R682T962/SDII/Textron Senior Design 1/Week 16 Showcase/prototype picture.jpg

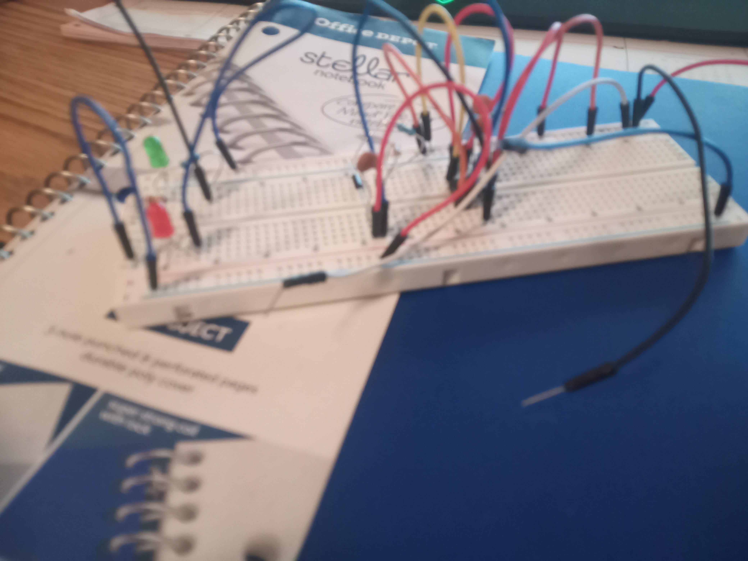
Textron Senior Design 1/Week 16 Showcase/prototype picture.jpg
