R682T962/SDII/README.txt

# SDII
Senior design 2 Textron project

Project Description can be found (these are duplicates):
SDII/Cooling Fan Monitor PCB Project Description.pdf
SDII/Textron Senior Design 1/Other/Cooling Fan Monitor PCB Project Description.pdf 

Work for each indivdual can be found in the files:
SDII/Textron Senior Design 1/Other/LTspice Models/
SDII/Textron Senior Design 2/Other/LTspice Models/
SDII/Textron Senior Design 2/Other/Altium/Melvin

Our references and meetings:
SDII/Journal/

Our current Prototype/math:
SDII/Textron Senior Design 2/Other/Current work summary/

.asc files are LTspice files.
