R682T962/SDII/Textron Senior Design 1/Week 11 Block Diagram/R682T962 Block diagram.pdf

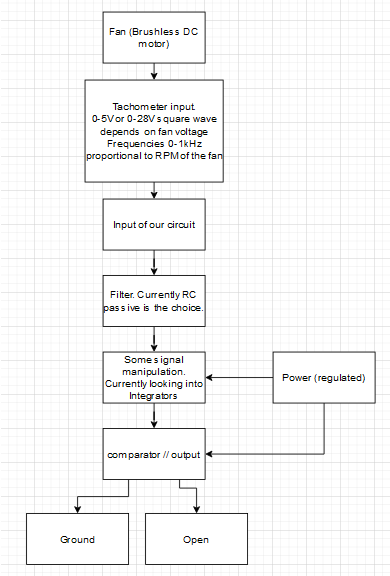
[picture p25: page 1]

Circuit Block diagram from Tachometere input

Block Diagram of the whole circuit

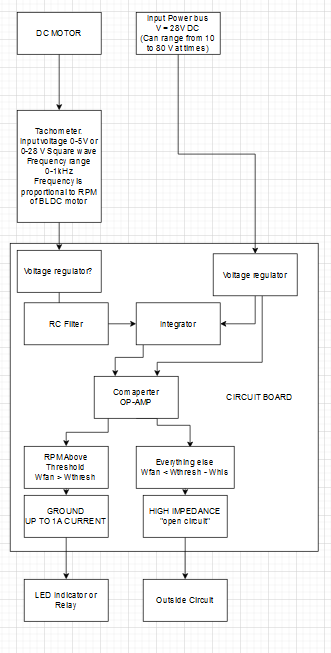
[picture p26: figure]
