R682T962/SDII/Textron Senior Design 1/Week 6 Project planning paper/Individual Skills Matrix_Mel.xlsx

 | Basic | Intermed | Adv | Want to Learn | This is about your experience level in various catagories. There are no right or wrong answers! This is a self-assessment scale, and each person may have a different 'value' for what basic, intermediate, and advanced means.
Software
Dev. methods |  |  |  |  | Agile, SCRUM, Waterfall, Lean, Feature Driven, etc.
Dev. Environ. | X |  |  |  | exposure to build, test, debug, compile, etc.
Config. Mgmt. |  |  |  |  | processes, tools, methodologies
Debug tools |  |  |  |  | simulators, emulators, probes, etc.
Create Code | X |  |  |  | exposure Java, JSON, C++, C#, etc.
Flowchart | X |  |  |  | standard symbology, can you prototype code with flowchart
Protocols |  |  |  |  | comms, streams, templates, patterns, etc.
Data security |  |  |  |  | data at rest, during transport, I&A levels, etc.
Database |  |  |  |  | Oracle, Sybase, MS-SQL, SQL, Access, etc.
Electrical
Power devices |  |  |  |  | FET, IGBT, NPN/PNP, MOV, etc.
Filters |  |  |  |  | line, tank trap, HF noise, ripple, etc.
Amplifiers | X |  |  |  | band pass, low pass, power line, HF, LF, etc.
Comms |  |  |  |  | communications over a serial bus of some kind, voip, slip, etc
Power supply |  |  |  |  | linear, switching, buck, boost, etc.
Converters |  |  |  |  | analog to digital, digital to analog, voltage to current, etc.
Logical | X |  |  |  | basic gates and respresentation via schematic
Simulation |  |  |  |  | schematic capture to sim, VHDL to sim, etc.
RF devices |  |  |  |  | antenna design, bluetooth, wifi, walkies, etc.
Prog. devices |  |  |  |  | FPGA, PLD, PLA, SOC, etc.
Computing
Single board |  |  |  |  | optimized for specific use, general purpose, etc.
Operating Sys | X |  |  |  | Windows, Unix, RTOS, etc.
Interfaces |  |  |  |  | OSI reference model,
Networks |  |  |  |  | star, token ring, bus, line, tree, mesh, etc.
Microprocessor |  |  |  |  | RISC, multi-core, low power, 8/16/32/64 bit, multi-thread
Microcontroller |  |  |  |  | on-board peripherals added to microprocessor
General
Prog. Controller | X |  |  |  | state machines, RLL, ladder, etc.
I/O modules | X |  |  |  | dry contact in/out, AC in/out, DC in/out, analog in/out, etc.
Sensors | X |  |  |  | capacitance, ultrasonic, IR, inductive, light, heat, etc.
Actuators |  |  |  |  | linear, push-pull, rotational, etc.
Motors | X |  |  |  | DC, brushless, AC, stepper, etc.
Solenoids |  |  |  |  | translate ele to mech, control flow, control power, etc.
Engr. Business
Requirements | X |  |  |  | the life cycle of requirements from gathering to final test
Trade Study |  |  |  |  | how-to do, when to do, making decisions on
Diagraming |  |  |  |  | flow, acquisition, resource, etc.
Tech Writing | X |  |  |  | style, grammar, user manuals, etc.
Communication |  | X |  |  | how to present to different kinds of audiences
Statement of Work |  | X |  |  | seen one, written one, used one, etc.
Conduct Research
Library |  | X |  |  | reference library vs all things Google
Tech Journals |  | X |  |  | where to look for specific industry tech data
Market | X |  |  |  | how to find the market for a specific kind of device
Product analysis |  | X |  |  | how to compare and weight features
Regulatory |  |  |  |  | Gov, industry, agency, compliance, restrictions, etc.
Standards |  |  |  |  | best practices, fielding devices, industry standards, etc.
Project Mgmt
Team organization |  | X
Minutes | X
Metrics | X
Schedule |  | X
Cost |  | X
Tracking |  | X
Visibility |  | X
Presentation |  | X
Reporting |  | X
 | Need intro | Have used | Can teach | Want to Learn
Oscilloscope | X |  |  | X
Logic Analyzer | X |  |  | X
DVM | X |  |  | X
Current probe | X |  |  | X
Freq. Analyzer | X |  |  | X
Spectrum Analyzer | X |  |  | X
Device programmer | X |  |  | X
Soldering iron |  | X |  | X
De-soldering station | X |  |  | X
Breadboard | X |  |  | X
Point-to-point |  |  |  | X
Perf-board |  |  |  | X
3-D Printer |  |  |  | X
Laser Cutter | X |  |  | X
PCB Design |  |  |  | X
PCB Manufacture |  |  |  | X
Component level troubleshooting |  |  |  | X
