R682T962/SDII/Textron Senior Design 1/Week 6 Project planning paper/R682T962 Individual Skills Matrix.xlsx

 | Basic | Intermed | Adv | Want to Learn | This is about your experience level in various catagories. There are no right or wrong answers! This is a self-assessment scale, and each person may have a different 'value' for what basic, intermediate, and advanced means.
Software
Dev. methods | 1 |  |  |  | Agile, SCRUM, Waterfall, Lean, Feature Driven, etc.
Dev. Environ. |  | 1 |  |  | exposure to build, test, debug, compile, etc.
Config. Mgmt. | 1 |  |  |  | processes, tools, methodologies
Debug tools | 1 |  |  |  | simulators, emulators, probes, etc.
Create Code |  | 1 |  |  | exposure Java, JSON, C++, C#, etc.
Flowchart | 1 |  |  |  | standard symbology, can you prototype code with flowchart
Protocols | 1 |  |  |  | comms, streams, templates, patterns, etc.
Data security | 1 |  |  |  | data at rest, during transport, I&A levels, etc.
Database | 1 |  |  |  | Oracle, Sybase, MS-SQL, SQL, Access, etc.
Electrical
Power devices |  | 1 |  | 1 | FET, IGBT, NPN/PNP, MOV, etc.
Filters | 1 |  |  | 1 | line, tank trap, HF noise, ripple, etc.
Amplifiers | 1 |  |  | 1 | band pass, low pass, power line, HF, LF, etc.
Comms | 1 |  |  | 1 | communications over a serial bus of some kind, voip, slip, etc
Power supply | 1 |  |  | 1 | linear, switching, buck, boost, etc.
Converters |  | 1 |  | 1 | analog to digital, digital to analog, voltage to current, etc.
Logical |  | 1 |  | 1 | basic gates and respresentation via schematic
Simulation |  | 1 |  |  | schematic capture to sim, VHDL to sim, etc.
RF devices | 1 |  |  | 1 | antenna design, bluetooth, wifi, walkies, etc.
Prog. devices | 1 |  |  |  | FPGA, PLD, PLA, SOC, etc.
Computing
Single board | 1 |  |  |  | optimized for specific use, general purpose, etc.
Operating Sys | 1 |  |  |  | Windows, Unix, RTOS, etc.
Interfaces | 1 |  |  |  | OSI reference model,
Networks | 1 |  |  |  | star, token ring, bus, line, tree, mesh, etc.
Microprocessor | 1 |  |  |  | RISC, multi-core, low power, 8/16/32/64 bit, multi-thread
Microcontroller | 1 |  |  |  | on-board peripherals added to microprocessor
General
Prog. Controller | 1 |  |  |  | state machines, RLL, ladder, etc.
I/O modules |  | 1 |  | 1 | dry contact in/out, AC in/out, DC in/out, analog in/out, etc.
Sensors | 1 |  |  | 1 | capacitance, ultrasonic, IR, inductive, light, heat, etc.
Actuators | 1 |  |  |  | linear, push-pull, rotational, etc.
Motors | 1 |  |  | 1 | DC, brushless, AC, stepper, etc.
Solenoids | 1 |  |  | 1 | translate ele to mech, control flow, control power, etc.
Engr. Business
Requirements | 1 |  |  | 1 | the life cycle of requirements from gathering to final test
Trade Study | 1 |  |  | 1 | how-to do, when to do, making decisions on
Diagraming | 1 |  |  | 1 | flow, acquisition, resource, etc.
Tech Writing | 1 |  |  | 1 | style, grammar, user manuals, etc.
Communication | 1 |  |  | 1 | how to present to different kinds of audiences
Statement of Work | 1 |  |  | 1 | seen one, written one, used one, etc.
Conduct Research
Library |  | 1 |  | 1 | reference library vs all things Google
Tech Journals | 1 |  |  | 1 | where to look for specific industry tech data
Market | 1 |  |  | 1 | how to find the market for a specific kind of device
Product analysis | 1 |  |  | 1 | how to compare and weight features
Regulatory | 1 |  |  | 1 | Gov, industry, agency, compliance, restrictions, etc.
Standards | 1 |  |  | 1 | best practices, fielding devices, industry standards, etc.
Project Mgmt
Team organization |  | 1
Minutes | 1
Metrics | 1
Schedule |  | 1
Cost |  | 1
Tracking |  | 1
Visibility | 1
Presentation |  | 1
Reporting |  | 1
 | Need intro | Have used | Can teach | Want to Learn
Oscilloscope |  | 1
Logic Analyzer | 1
DVM | 1
Current probe | 1 |  |  | 1
Freq. Analyzer | 1 |  |  | 1
Spectrum Analyzer | 1 |  |  | 1
Device programmer | 1
Soldering iron |  | 1 |  | 1
De-soldering station | 1 |  |  | 1
Breadboard |  | 1
Point-to-point | 1
Perf-board | 1
3-D Printer |  | 1 |  | 1
Laser Cutter | 1 |  |  | 1
PCB Design | 1 |  |  | 1
PCB Manufacture | 1 |  |  | 1
Component level troubleshooting | 1 |  |  | 1
