R682T962/SDII/Textron Senior Design 1/Week 6 Project planning paper/Team Skills Matrix.xlsx

Sheet: Melvin St.John
 |  | Basic | Intermed | Adv | Want to Learn
Software
Dev. methods | 1
Dev. Environ. | 0 | 1
Config. Mgmt. | 1
Debug tools | 1
Create Code | 0 | 1
Flowchart | 0 | 1
Protocols | 1
Data security | 1
Database | 1
Electrical | 1
Power devices | 1 |  |  |  | 1
Filters | 0 | 1 |  |  | 1
Amplifiers | 0 | 1 |  |  | 1
Comms | 1 |  |  |  | 1
Power supply | 0 | 1 |  |  | 1
Converters | 1 |  |  |  | 1
Logical | 0 | 1 |  |  | 1
Simulation | 0 | 1 |  |  | 1
RF devices | 1 |  |  |  | 1
Prog. devices | 0 | 1 |  |  | 1
Computing | 1 |  |  |  | 1
Single board | 1 |  |  |  | 1
Operating Sys | 0 | 1 |  |  | 1
Interfaces | 0 | 1 |  |  | 1
Networks | 1 |  |  |  | 1
Microprocessor | 1 |  |  |  | 1
Microcontroller | 1 |  |  |  | 1
General | 1
Prog. Controller | 0 | 1 |  |  | 1
I/O modules | 0 | 1 |  |  | 1
Sensors | 0 | 1 |  |  | 1
Actuators | 1 |  |  |  | 1
Motors | 0 | 1 |  |  | 1
Solenoids | 1 |  |  |  | 1
Engr. Develop. | 1
Requirements | 0 | 1 |  |  | 1
Trade Study | 1 |  |  |  | 1
Diagraming | 1 |  |  |  | 1
Tech Writing | 0 | 1 |  |  | 1
Communication | 0 |  | 1 |  | 1
Statement of Work | 0 |  | 1 |  | 1
Conduct Research | 1
Library | 0 | 1 |  |  | 1
Tech Journals | 0 | 1 |  |  | 1
Market | 0 | 1 |  |  | 1
Product analysis | 0 |  | 1 |  | 1
Regulatory | 0 | 1 |  |  | 1
Standards | 0 | 1 |  |  | 1
Project Mgmt | 0 |  | 1
Team organization | 0 |  | 1 |  | 1
Minutes | 0 |  | 1
Metrics | 0 | 1 |  |  | 1
Schedule | 0 |  | 1 |  | 1
Cost | 0 |  | 1 |  | 1
Tracking | 0 | 1 |  |  | 1
Visibility | 0 |  | 1
Presentation | 0 |  | 1 |  | 1
Reporting | 0 |  | 1 |  | 1
 | 1
 | 1
 | #VALUE! | Need intro | Have used | Can teach | Want to Learn
Oscilloscope | 0 |  | 1 |  | 1
Logic Analyzer | 0 | 1 |  |  | 1
DVM | 0 | 1 |  |  | 1
Current probe | 0 |  | 1
Freq. Analyzer | 0 |  | 1 |  | 1
Spectrum Analyzer | 0 | 1 |  |  | 1
Device programmer | 0 | 1 |  |  | 1
Soldering iron | 0 |  | 1 | 1
De-soldering station | 0 | 1 |  |  | 1
Breadboard | 0 |  | 1 |  | 1
Point-to-point | 0 | 1 |  |  | 1
Perf-board | 0 | 1 |  |  | 1
3-D Printer | 0 | 1 |  |  | 1
Laser Cutter | 0 |  | 1 |  | 1
PCB Design | 0 | 1 |  |  | 1
PCB Manufacture | 0 | 1 |  |  | 1
Component level troubleshooting | 0 | 1 |  |  | 1
 | 1
 | 1
 | 1
 | 1
 | 1
 | 1

Sheet: Ayham Sabra
 |  | Basic | Intermed | Adv | Want to Learn
Software
Dev. methods | 1
Dev. Environ. | 0 | 1
Config. Mgmt. | 1
Debug tools | 1
Create Code | 0 |  | 1 |  | 1
Flowchart | 1 |  |  |  | 1
Protocols | 1 |  |  |  | 1
Data security | 1 |  |  |  | 1
Database | 1 |  |  |  | 1
Electrical
Power devices | 0 |  | 1 |  | 1
Filters | 0 | 1 |  |  | 1
Amplifiers | 0 | 1 |  |  | 1
Comms | 1 |  |  |  | 1
Power supply | 0 | 1 |  |  | 1
Converters | 0 | 1 |  |  | 1
Logical | 0 | 1 |  |  | 1
Simulation | 0 |  | 1 |  | 1
RF devices | 1 |  |  |  | 1
Prog. devices | 1
Computing
Single board | 0 | 1 |  |  | 1
Operating Sys | 0 | 1
Interfaces | 1
Networks | 1
Microprocessor | 1
Microcontroller | 1 |  |  |  | 1
General
Prog. Controller | 1
I/O modules | 0 |  | 1 |  | 1
Sensors | 0 | 1 |  |  | 1
Actuators | 0 | 1 |  |  | 1
Motors | 0 | 1 |  |  | 1
Solenoids | 0 | 1 |  |  | 1
Engr. Develop.
Requirements | 0 | 1 |  |  | 1
Trade Study | 1 |  |  |  | 1
Diagraming | 1 |  |  |  | 1
Tech Writing | 1 |  |  |  | 1
Communication | 0 | 1 |  |  | 1
Statement of Work | 1 |  |  |  | 1
Conduct Research
Library | 0 |  | 1 |  | 1
Tech Journals | 1 |  |  |  | 1
Market | 1 |  |  |  | 1
Product analysis | 1 |  |  |  | 1
Regulatory | 1 |  |  |  | 1
Standards | 1 |  |  |  | 1
Project Mgmt | 1
Team organization | 0 |  | 1 |  | 1
Minutes | 0 | 1
Metrics | 1
Schedule | 0 |  | 1 |  | 1
Cost | 0 |  | 1 |  | 1
Tracking | 1 |  |  |  | 1
Visibility | 1 |  |  |  | 1
Presentation | 0 | 1 |  |  | 1
Reporting | 0 | 1 |  |  | 1
 |  | Need intro | Have used | Can teach | Want to Learn
Oscilloscope | 0 |  | 1 |  | 1
Logic Analyzer | 0 | 1 |  |  | 1
DVM | 0 | 1 |  |  | 1
Current probe | 0 | 1 |  |  | 1
Freq. Analyzer | 0 | 1 |  |  | 1
Spectrum Analyzer | 0 | 1 |  |  | 1
Device programmer | 0 | 1
Soldering iron | 0 |  | 1 |  | 1
De-soldering station | 0 | 1 |  |  | 1
Breadboard | 0 |  | 1
Point-to-point | 0 | 1
Perf-board | 0 | 1
3-D Printer | 0 |  | 1 |  | 1
Laser Cutter | 1
PCB Design | 0 | 1 |  |  | 1
PCB Manufacture | 0 | 1 |  |  | 1
Component level troubleshooting | 0 | 1 |  |  | 1

Sheet: Cody White
 |  | Basic | Intermed | Adv | Want to Learn
Software
Dev. methods |  | 1
Dev. Environ. |  | 1
Config. Mgmt. |  |  | 1
Debug tools |  |  | 1
Create Code |  | 1 |  |  | 1
Flowchart |  |  | 1
Protocols |  |  | 1
Data security |  | 1 |  |  | 1
Database | 1
Electrical
Power devices |  |  | 1 |  | 1
Filters |  | 1 |  |  | 1
Amplifiers |  | 1 |  |  | 1
Comms |  | 1 |  |  | 1
Power supply |  |  | 1 |  | 1
Converters |  |  | 1 |  | 1
Logical |  |  | 1 |  | 1
Simulation |  |  | 1 |  | 1
RF devices | 1 |  |  |  | 1
Prog. devices | 1 |  |  |  | 1
Computing
Single board |  | 1
Operating Sys |  | 1
Interfaces | 1
Networks |  | 1
Microprocessor | 1 |  |  |  | 1
Microcontroller | 1 |  |  |  | 1
General
Prog. Controller |  | 1 |  |  | 1
I/O modules |  | 1 |  |  | 1
Sensors |  | 1 |  |  | 1
Actuators | 1 |  |  |  | 1
Motors |  | 1 |  |  | 1
Solenoids |  | 1 |  |  | 1
Engr. Develop.
Requirements |  |  | 1
Trade Study |  | 1 |  |  | 1
Diagraming |  |  | 1
Tech Writing |  | 1 |  |  | 1
Communication |  |  | 1
Statement of Work |  |  | 1
Conduct Research
Library |  |  | 1
Tech Journals |  |  | 1
Market |  | 1
Product analysis |  |  | 1
Regulatory |  | 1
Standards |  |  | 1
Project Mgmt
Team organization |  |  | 1
Minutes |  |  | 1
Metrics |  |  | 1
Schedule |  |  | 1
Cost |  |  | 1
Tracking |  |  | 1
Visibility |  |  | 1
Presentation |  |  |  | 1
Reporting |  |  |  | 1
 |  | Need intro | Have used | Can teach | Want to Learn
Oscilloscope |  |  | 1 |  | 1
Logic Analyzer |  | 1 |  |  | 1
DVM |  | 1 |  |  | 1
Current probe |  |  | 1 |  | 1
Freq. Analyzer |  | 1 |  |  | 1
Spectrum Analyzer |  | 1 |  |  | 1
Device programmer |  | 1 |  |  | 1
Soldering iron |  |  | 1 |  | 1
De-soldering station |  | 1 |  |  | 1
Breadboard |  |  | 1 |  | 1
Point-to-point |  | 1 |  |  | 1
Perf-board |  | 1 |  |  | 1
3-D Printer |  |  | 1 |  | 1
Laser Cutter |  |  | 1 |  | 1
PCB Design |  | 1 |  |  | 1
PCB Manufacture |  | 1 |  |  | 1
Component level troubleshooting |  |  | 1 |  | 1

Sheet: person4
 | Basic | Intermed | Adv | Want to Learn
Software
Dev. methods
Dev. Environ.
Config. Mgmt.
Debug tools
Create Code
Flowchart
Protocols
Data security
Database
Electrical
Power devices
Filters
Amplifiers
Comms
Power supply
Converters
Logical
Simulation
RF devices
Prog. devices
Computing
Single board
Operating Sys
Interfaces
Networks
Microprocessor
Microcontroller
General
Prog. Controller
I/O modules
Sensors
Actuators
Motors
Solenoids
Engr. Develop.
Requirements
Trade Study
Diagraming
Tech Writing
Communication
Statement of Work
Conduct Research
Library
Tech Journals
Market
Product analysis
Regulatory
Standards
Project Mgmt
Team organization
Minutes
Metrics
Schedule
Cost
Tracking
Visibility
Presentation
Reporting
 | Need intro | Have used | Can teach | Want to Learn
Oscilloscope
Logic Analyzer
DVM
Current probe
Freq. Analyzer
Spectrum Analyzer
Device programmer
Soldering iron
De-soldering station
Breadboard
Point-to-point
Perf-board
3-D Printer
Laser Cutter
PCB Design
PCB Manufacture
Component level troubleshooting

Sheet: person5
 | Basic | Intermed | Adv | Want to Learn
Software
Dev. methods
Dev. Environ.
Config. Mgmt.
Debug tools
Create Code
Flowchart
Protocols
Data security
Database
Electrical
Power devices
Filters
Amplifiers
Comms
Power supply
Converters
Logical
Simulation
RF devices
Prog. devices
Computing
Single board
Operating Sys
Interfaces
Networks
Microprocessor
Microcontroller
General
Prog. Controller
I/O modules
Sensors
Actuators
Motors
Solenoids
Engr. Develop.
Requirements
Trade Study
Diagraming
Tech Writing
Communication
Statement of Work
Conduct Research
Library
Tech Journals
Market
Product analysis
Regulatory
Standards
Project Mgmt
Team organization
Minutes
Metrics
Schedule
Cost
Tracking
Visibility
Presentation
Reporting
 | Need intro | Have used | Can teach | Want to Learn
Oscilloscope
Logic Analyzer
DVM
Current probe
Freq. Analyzer
Spectrum Analyzer
Device programmer
Soldering iron
De-soldering station
Breadboard
Point-to-point
Perf-board
3-D Printer
Laser Cutter
PCB Design
PCB Manufacture
Component level troubleshooting

Sheet: person6
 | Basic | Intermed | Adv | Want to Learn
Software
Dev. methods
Dev. Environ.
Config. Mgmt.
Debug tools
Create Code
Flowchart
Protocols
Data security
Database
Electrical
Power devices
Filters
Amplifiers
Comms
Power supply
Converters
Logical
Simulation
RF devices
Prog. devices
Computing
Single board
Operating Sys
Interfaces
Networks
Microprocessor
Microcontroller
General
Prog. Controller
I/O modules
Sensors
Actuators
Motors
Solenoids
Engr. Develop.
Requirements
Trade Study
Diagraming
Tech Writing
Communication
Statement of Work
Conduct Research
Library
Tech Journals
Market
Product analysis
Regulatory
Standards
Project Mgmt
Team organization
Minutes
Metrics
Schedule
Cost
Tracking
Visibility
Presentation
Reporting
 | Need intro | Have used | Can teach | Want to Learn
Oscilloscope
Logic Analyzer
DVM
Current probe
Freq. Analyzer
Spectrum Analyzer
Device programmer
Soldering iron
De-soldering station
Breadboard
Point-to-point
Perf-board
3-D Printer
Laser Cutter
PCB Design
PCB Manufacture
Component level troubleshooting

Sheet: person7
 | Basic | Intermed | Adv | Want to Learn
Software
Dev. methods
Dev. Environ.
Config. Mgmt.
Debug tools
Create Code
Flowchart
Protocols
Data security
Database
Electrical
Power devices
Filters
Amplifiers
Comms
Power supply
Converters
Logical
Simulation
RF devices
Prog. devices
Computing
Single board
Operating Sys
Interfaces
Networks
Microprocessor
Microcontroller
General
Prog. Controller
I/O modules
Sensors
Actuators
Motors
Solenoids
Engr. Develop.
Requirements
Trade Study
Diagraming
Tech Writing
Communication
Statement of Work
Conduct Research
Library
Tech Journals
Market
Product analysis
Regulatory
Standards
Project Mgmt
Team organization
Minutes
Metrics
Schedule
Cost
Tracking
Visibility
Presentation
Reporting
 | Need intro | Have used | Can teach | Want to Learn
Oscilloscope
Logic Analyzer
DVM
Current probe
Freq. Analyzer
Spectrum Analyzer
Device programmer
Soldering iron
De-soldering station
Breadboard
Point-to-point
Perf-board
3-D Printer
Laser Cutter
PCB Design
PCB Manufacture
Component level troubleshooting

Sheet: Team skills rollup
 | None | Basic | Intermed | Adv | Want to Learn
Software
Dev. methods | 2 | 1 | 0 | 0 | 0
Dev. Environ. | 0 | 3 | 0 | 0 | 0
Config. Mgmt. | 2 | 0 | 1 | 0 | 0
Debug tools | 2 | 0 | 1 | 0 | 0
Create Code | 0 | 2 | 1 | 0 | 2
Flowchart | 1 | 1 | 1 | 0 | 1
Protocols | 2 | 0 | 1 | 0 | 1
Data security | 2 | 1 | 0 | 0 | 2
Database | 3 | 0 | 0 | 0 | 1
Electrical
Power devices | 1 | 0 | 2 | 0 | 3
Filters | 0 | 3 | 0 | 0 | 3
Amplifiers | 0 | 3 | 0 | 0 | 3
Comms | 2 | 1 | 0 | 0 | 3
Power supply | 0 | 2 | 1 | 0 | 3
Converters | 1 | 1 | 1 | 0 | 3
Logical | 0 | 2 | 1 | 0 | 3
Simulation | 0 | 1 | 2 | 0 | 3
RF devices | 3 | 0 | 0 | 0 | 3
Prog. devices | 2 | 1 | 0 | 0 | 2
Computing
Single board | 1 | 2 | 0 | 0 | 2
Operating Sys | 0 | 3 | 0 | 0 | 1
Interfaces | 2 | 1 | 0 | 0 | 1
Networks | 2 | 1 | 0 | 0 | 1
Microprocessor | 3 | 0 | 0 | 0 | 2
Microcontroller | 3 | 0 | 0 | 0 | 3
General
Prog. Controller | 1 | 2 | 0 | 0 | 2
I/O modules | 0 | 2 | 1 | 0 | 3
Sensors | 0 | 3 | 0 | 0 | 3
Actuators | 2 | 1 | 0 | 0 | 3
Motors | 0 | 3 | 0 | 0 | 3
Solenoids | 1 | 2 | 0 | 0 | 3
Engr. Develop.
Requirements | 0 | 2 | 1 | 0 | 2
Trade Study | 2 | 1 | 0 | 0 | 3
Diagraming | 2 | 0 | 1 | 0 | 2
Tech Writing | 1 | 2 | 0 | 0 | 3
Communication | 0 | 1 | 2 | 0 | 2
Statement of Work | 1 | 0 | 2 | 0 | 2
Conduct Research
Library | 0 | 1 | 2 | 0 | 2
Tech Journals | 1 | 1 | 1 | 0 | 2
Market | 1 | 2 | 0 | 0 | 2
Product analysis | 1 | 0 | 2 | 0 | 2
Regulatory | 1 | 2 | 0 | 0 | 2
Standards | 1 | 1 | 1 | 0 | 2
Project Mgmt
Team organization | 0 | 0 | 3 | 0 | 2
Minutes | 0 | 1 | 2 | 0 | 0
Metrics | 1 | 1 | 1 | 0 | 1
Schedule | 0 | 0 | 3 | 0 | 2
Cost | 0 | 0 | 3 | 0 | 2
Tracking | 1 | 1 | 1 | 0 | 2
Visibility | 1 | 0 | 2 | 0 | 1
Presentation | 0 | 1 | 1 | 1 | 2
Reporting | 0 | 1 | 1 | 1 | 2
 |  | Need intro | Have used | Can teach | Want to Learn
Oscilloscope |  | 0 | 3 | 0 | 3
Logic Analyzer |  | 3 | 0 | 0 | 3
DVM |  | 3 | 0 | 0 | 3
Current probe |  | 1 | 2 | 0 | 2
Freq. Analyzer |  | 2 | 1 | 0 | 3
Spectrum Analyzer |  | 3 | 0 | 0 | 3
Device programmer |  | 3 | 0 | 0 | 2
Soldering iron |  | 0 | 3 | 1 | 2
De-soldering station |  | 3 | 0 | 0 | 3
Breadboard |  | 0 | 3 | 0 | 2
Point-to-point |  | 3 | 0 | 0 | 2
Perf-board |  | 3 | 0 | 0 | 2
3-D Printer |  | 1 | 2 | 0 | 3
Laser Cutter |  | 0 | 2 | 0 | 2
PCB Design |  | 3 | 0 | 0 | 3
PCB Manufacture |  | 3 | 0 | 0 | 3
Component level troubleshooting |  | 2 | 1 | 0 | 3
