R682T962/SDII/Textron Senior Design 2/Other/Current work summary/All math for circuit.pdf

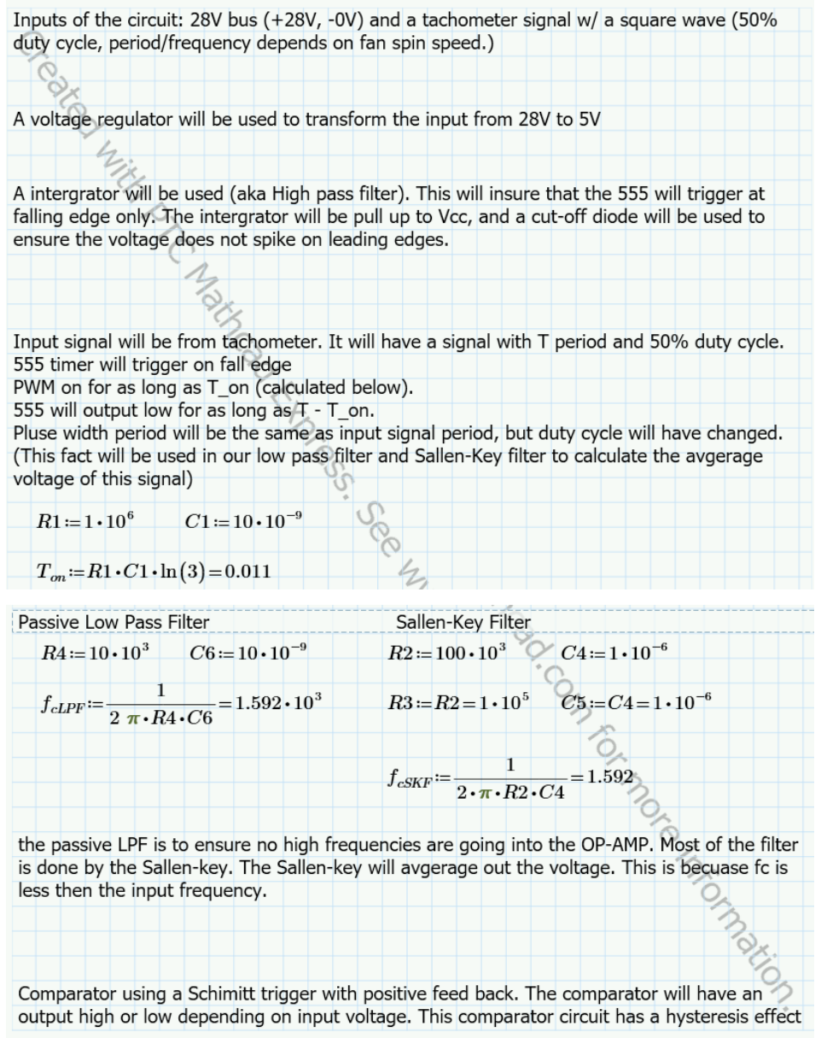
[picture p27: page 1]

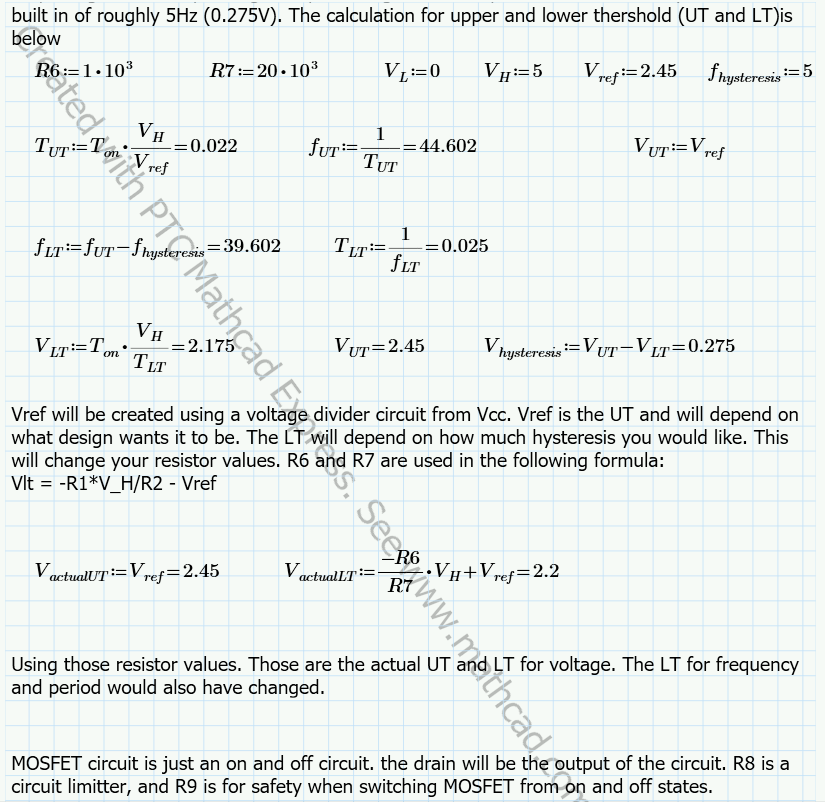
[picture p28: figure]
