R682T962/SDII/Textron Senior Design 1/Week 16 Showcase/Prototype outputs.png

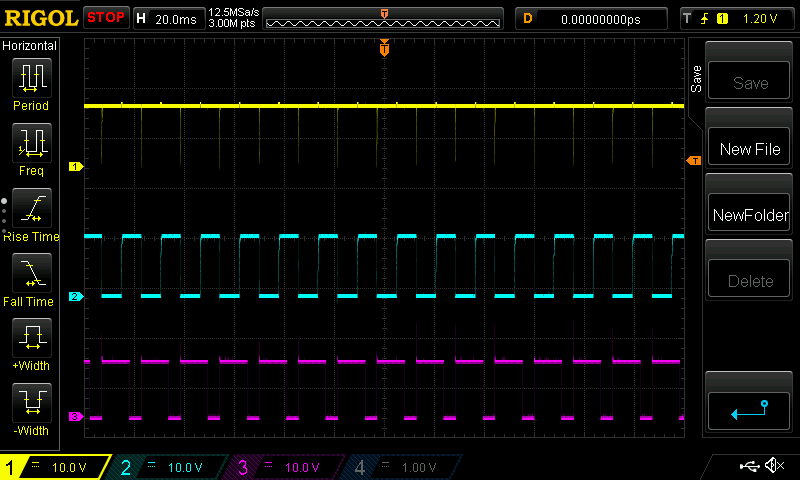
Textron Senior Design 1/Week 16 Showcase/Prototype outputs.png
