R682T962/SDII/Textron Senior Design 1/Other/Data/FFT code and results/Try 3 10-31/FFT graphs .docx

Data 5ns 12V data9

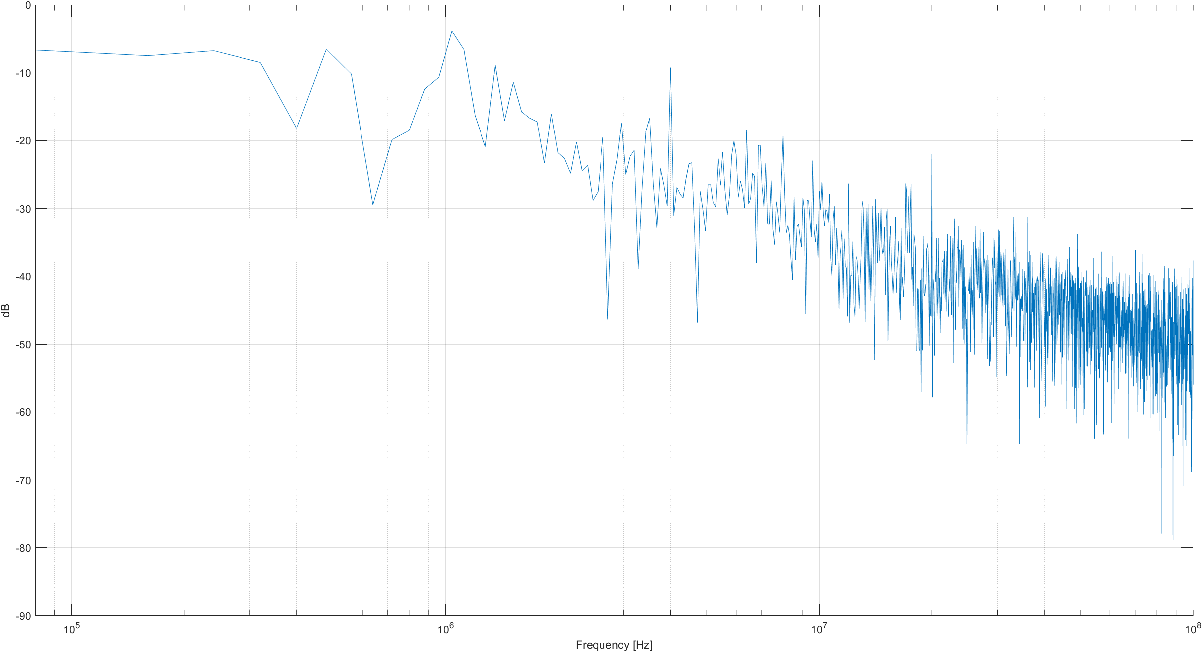
[picture p30: figure]

Data 5ns 12V data10

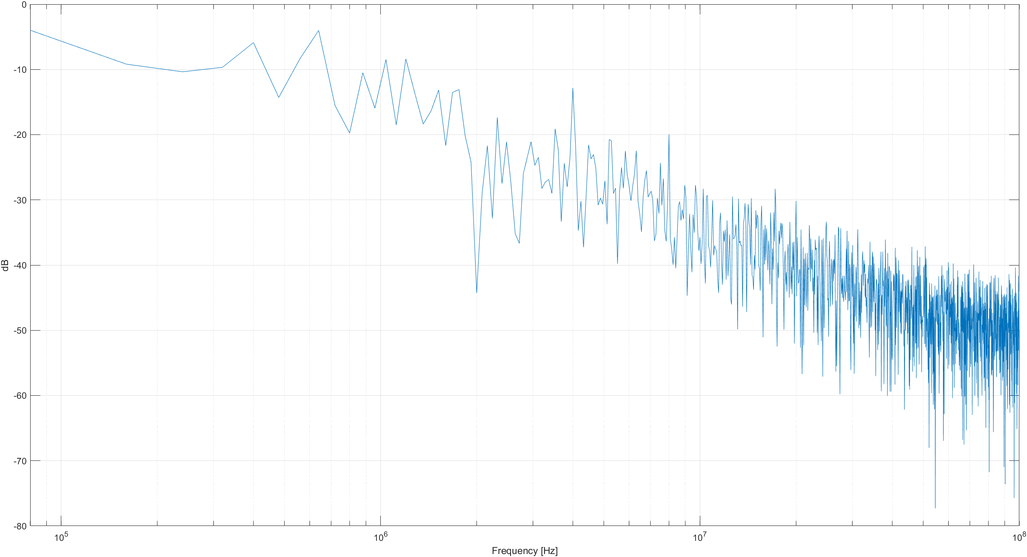
[picture p31: figure]

Data 5ns 12V data11

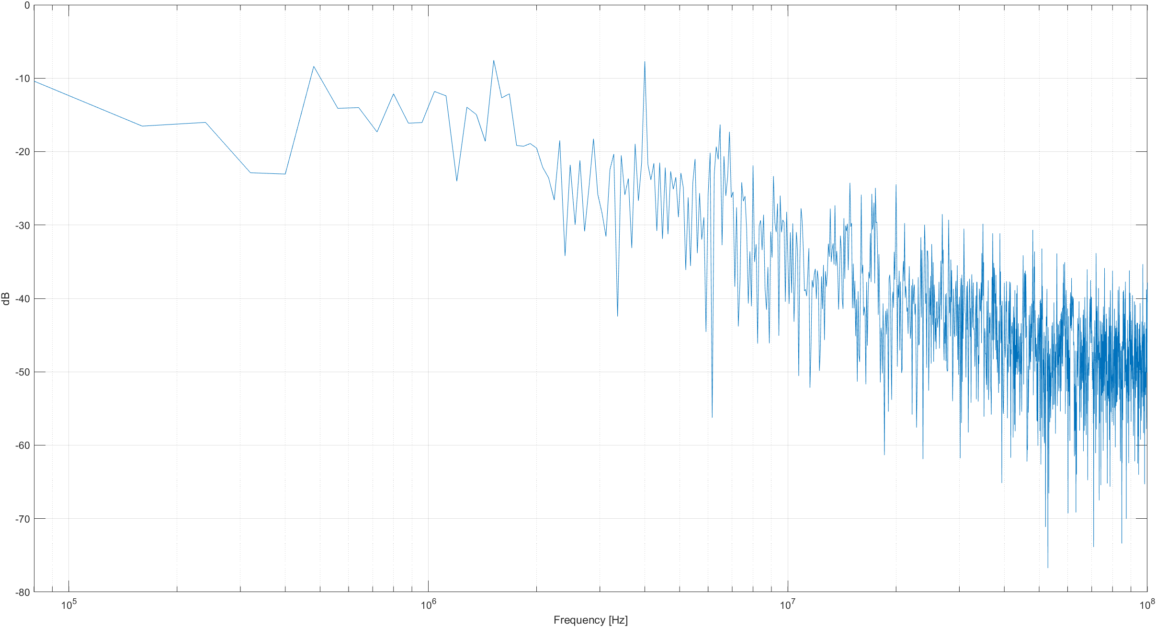
[picture p32: figure]

Data 100ns 12V data9

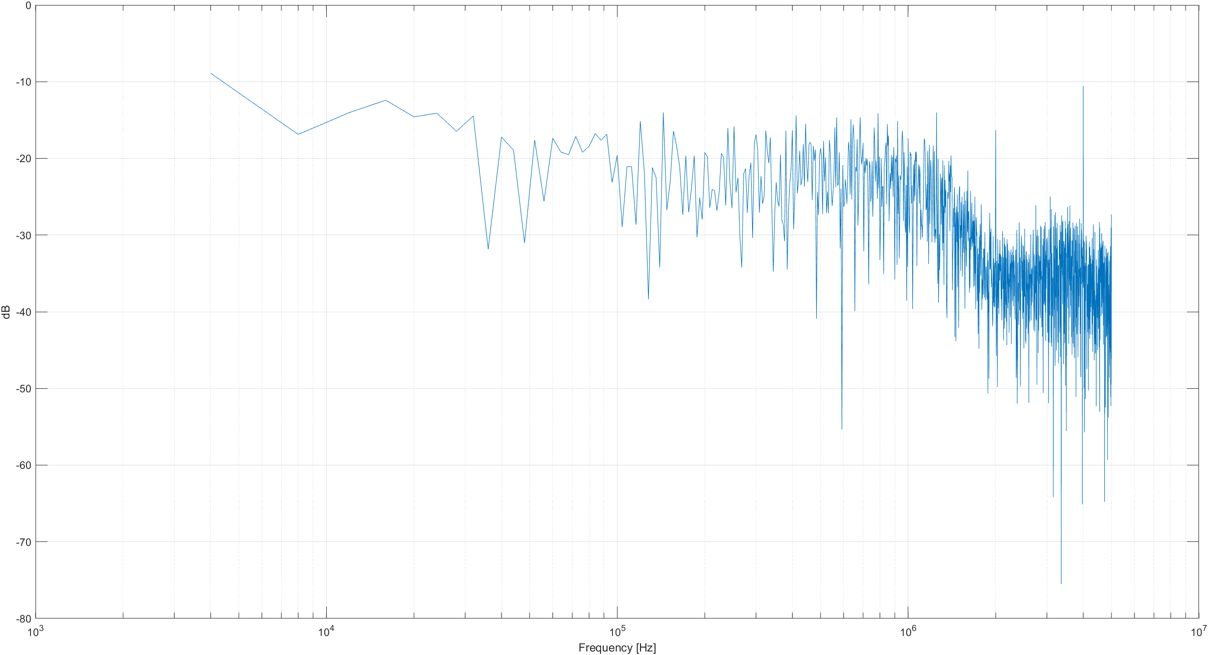
[picture p33: figure]

Data 100ns 12V data10

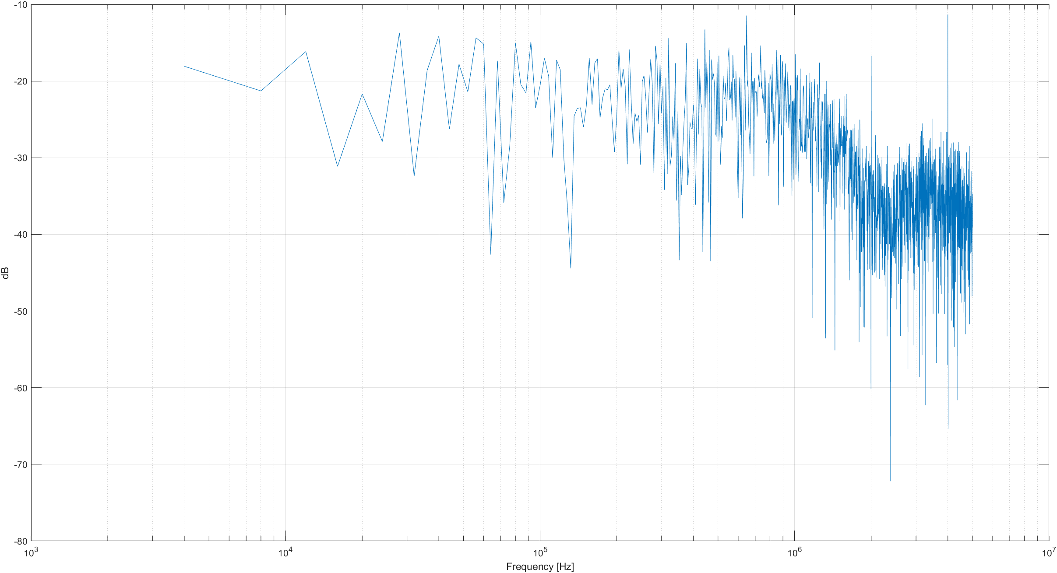
[picture p34: figure]

Data 100ns 12V data11

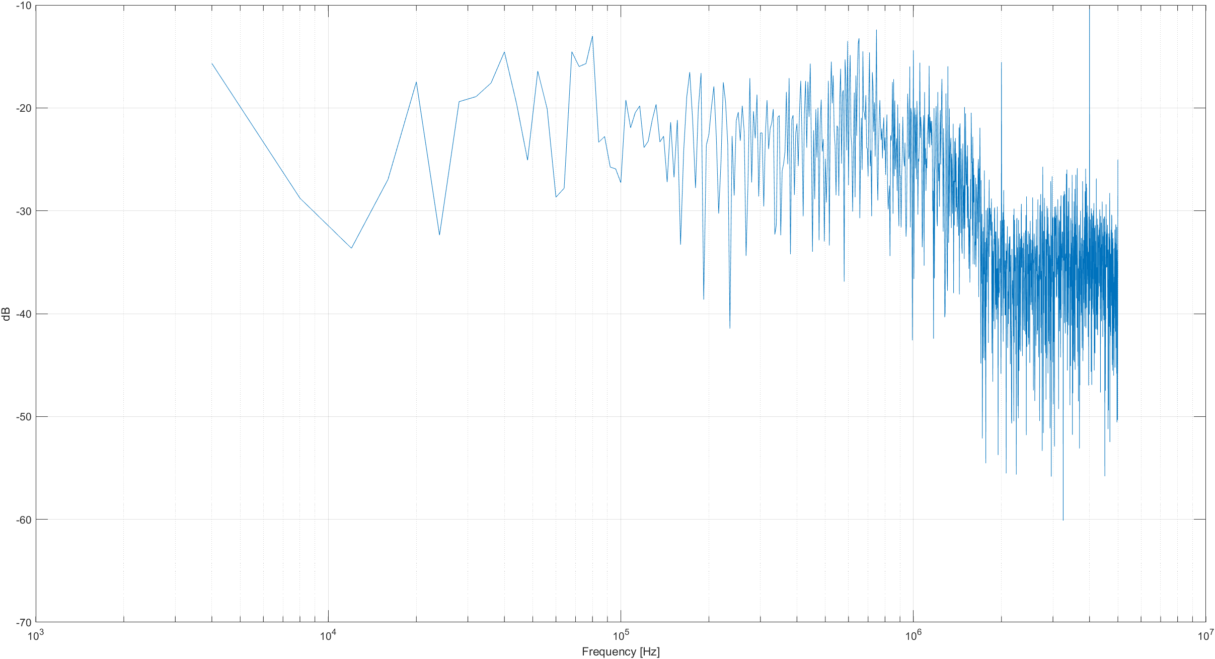
[picture p35: figure]

Data 1ms 12V data09, with signal

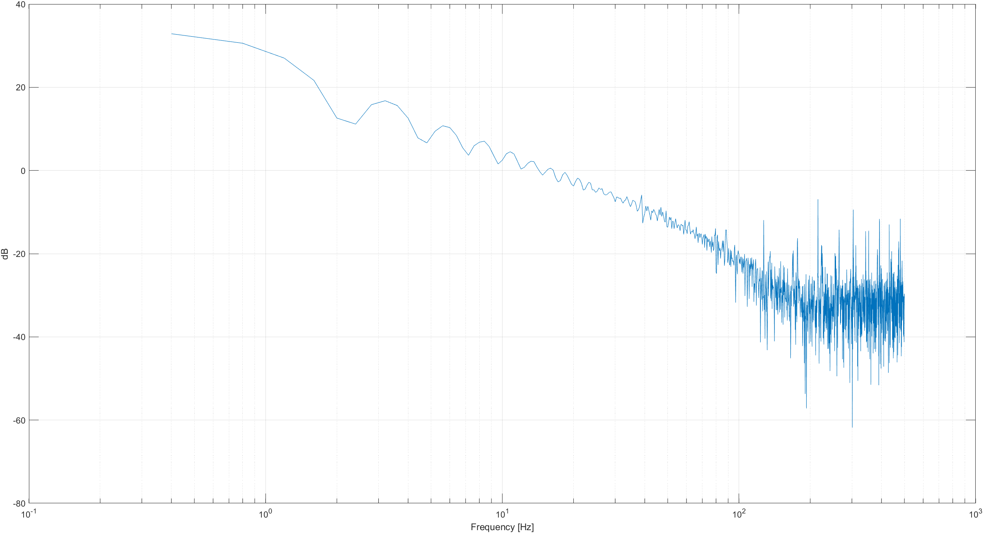
[picture p36: figure]
