R682T962/SDII/Textron Senior Design 1/Other/Data/FFT code and results/extra MATLAB/fft 12v 5ms part.docx

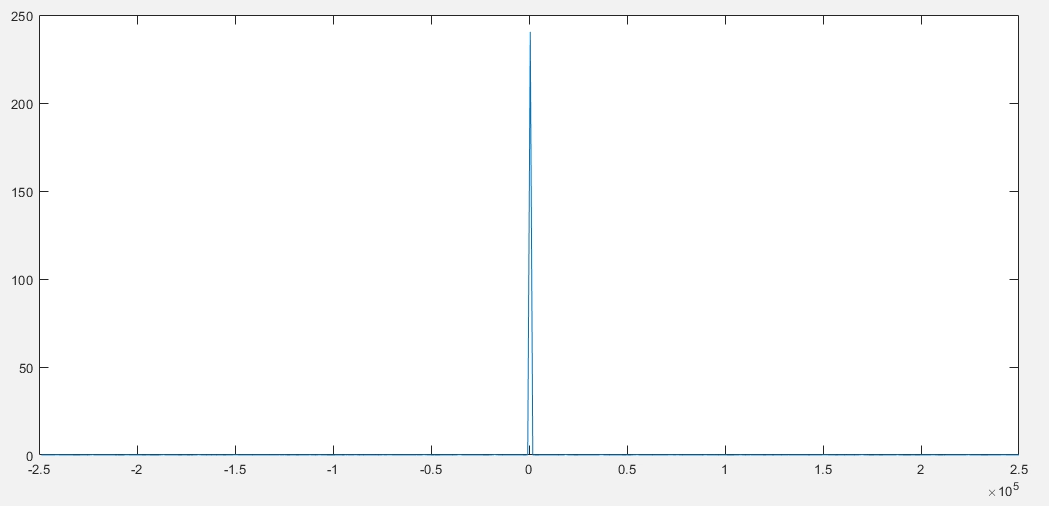
[picture p37: figure]
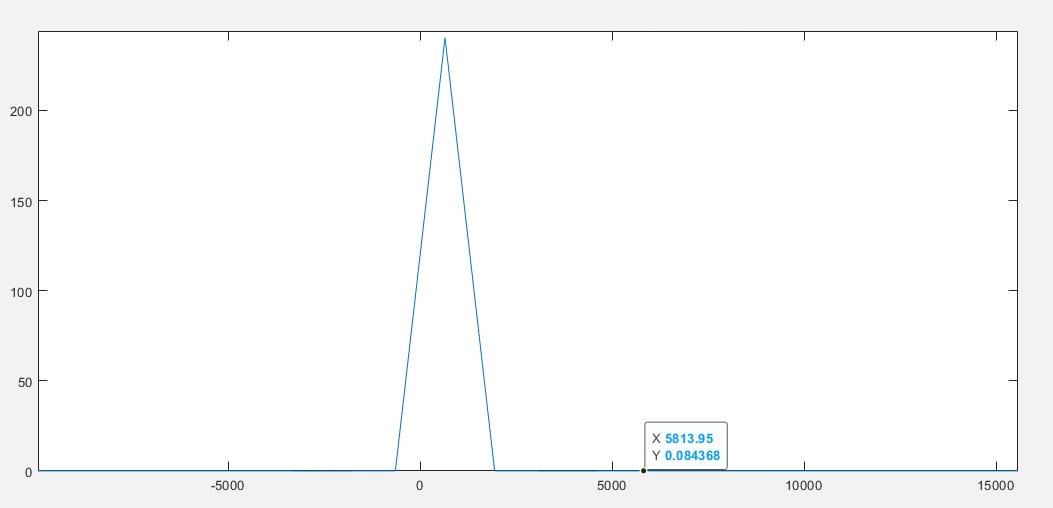
[picture p38: figure]
