R682T962/SDII/Textron Senior Design 1/Other/Data/FFT code and results/Try 1/Scope graph 10-15..docx

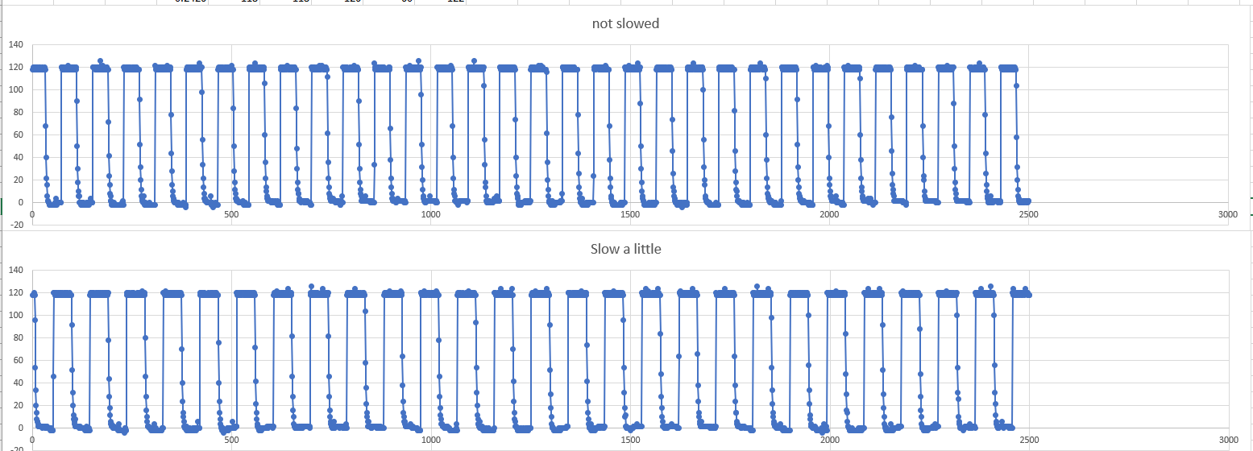
[picture p39: figure]
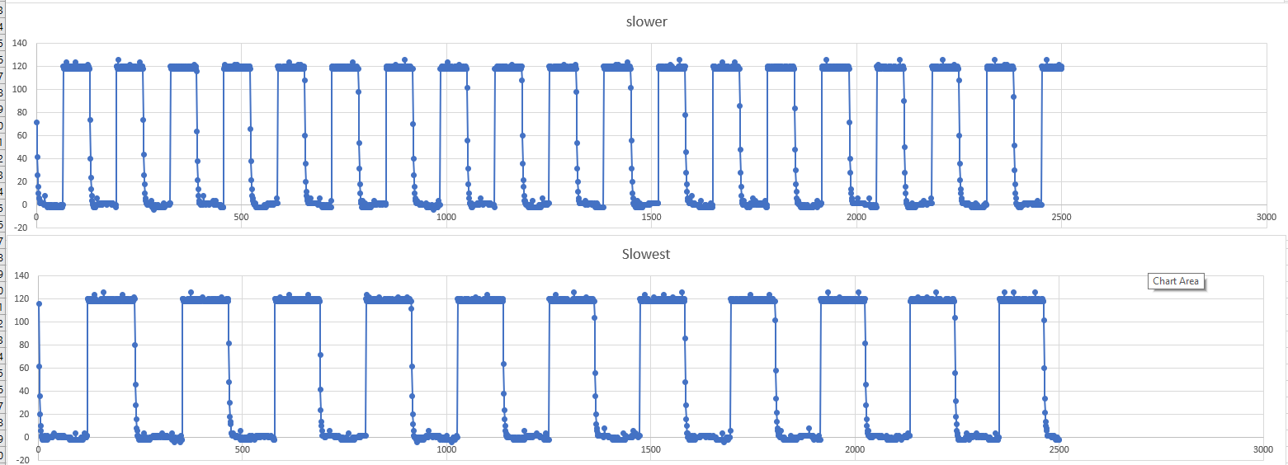
[picture p40: figure]
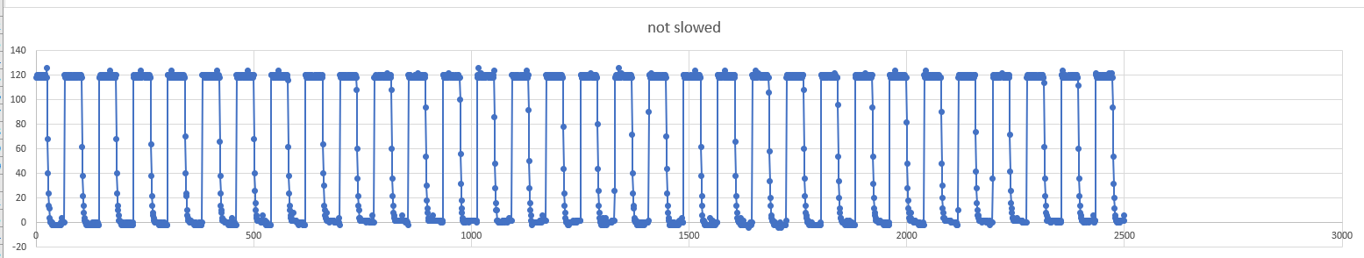
[picture p41: figure]
