R682T962/SDII/Textron Senior Design 1/Other/Data/FFT code and results/Try 2/Results.docx

Signal not slowed 1:

Original

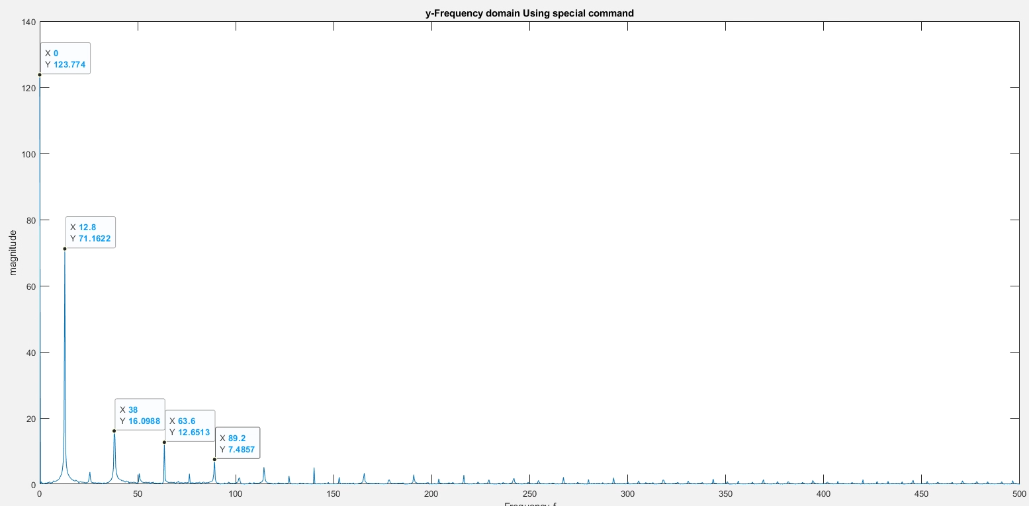
[picture p42: figure]

Noise only

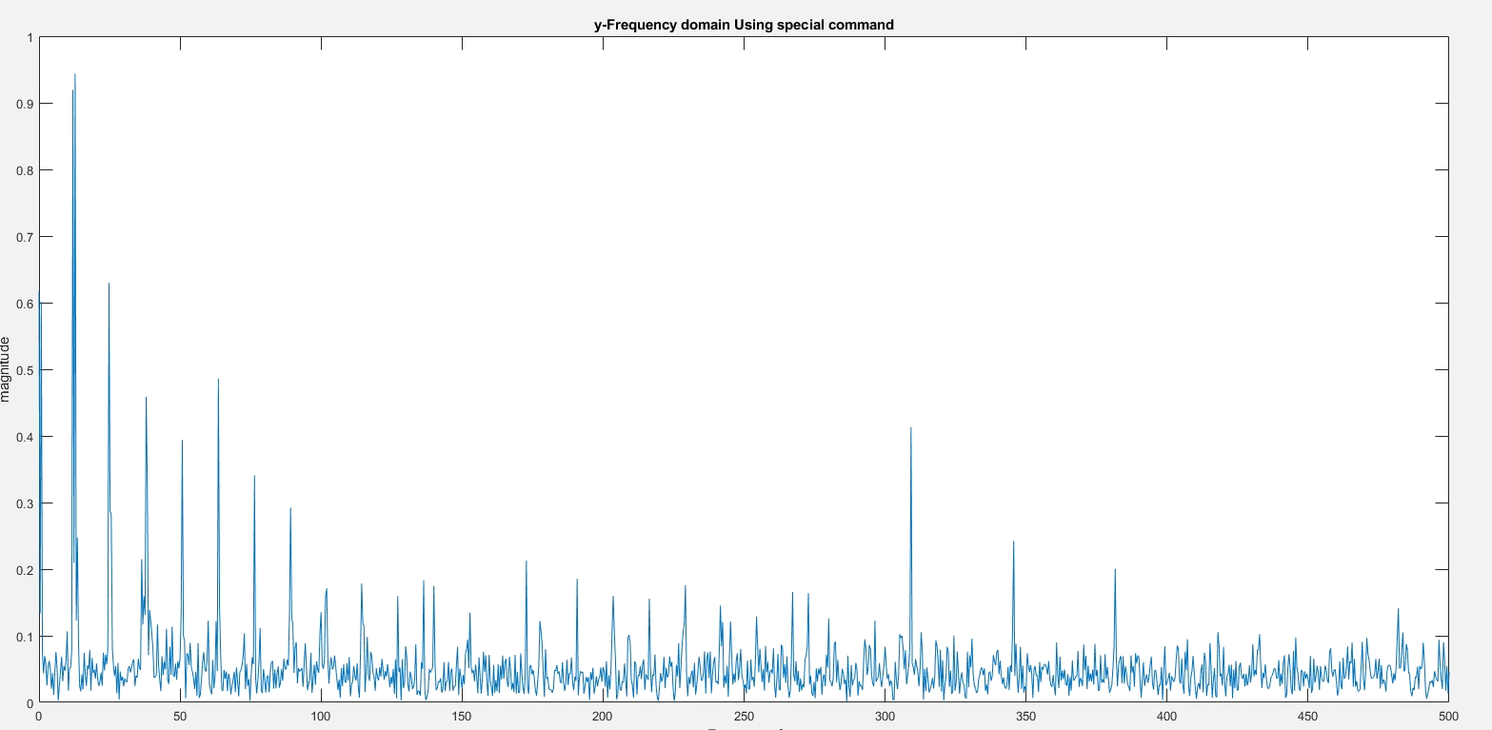
[picture p43: figure]

Signal Slowed:

Original

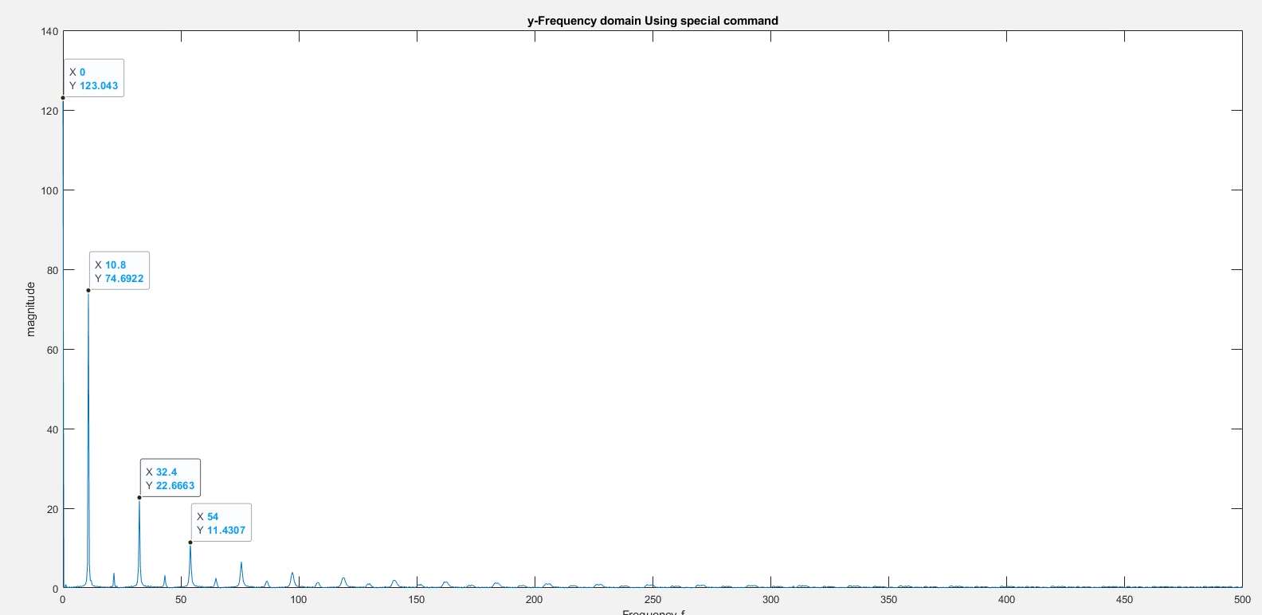
[picture p44: figure]

Noise only

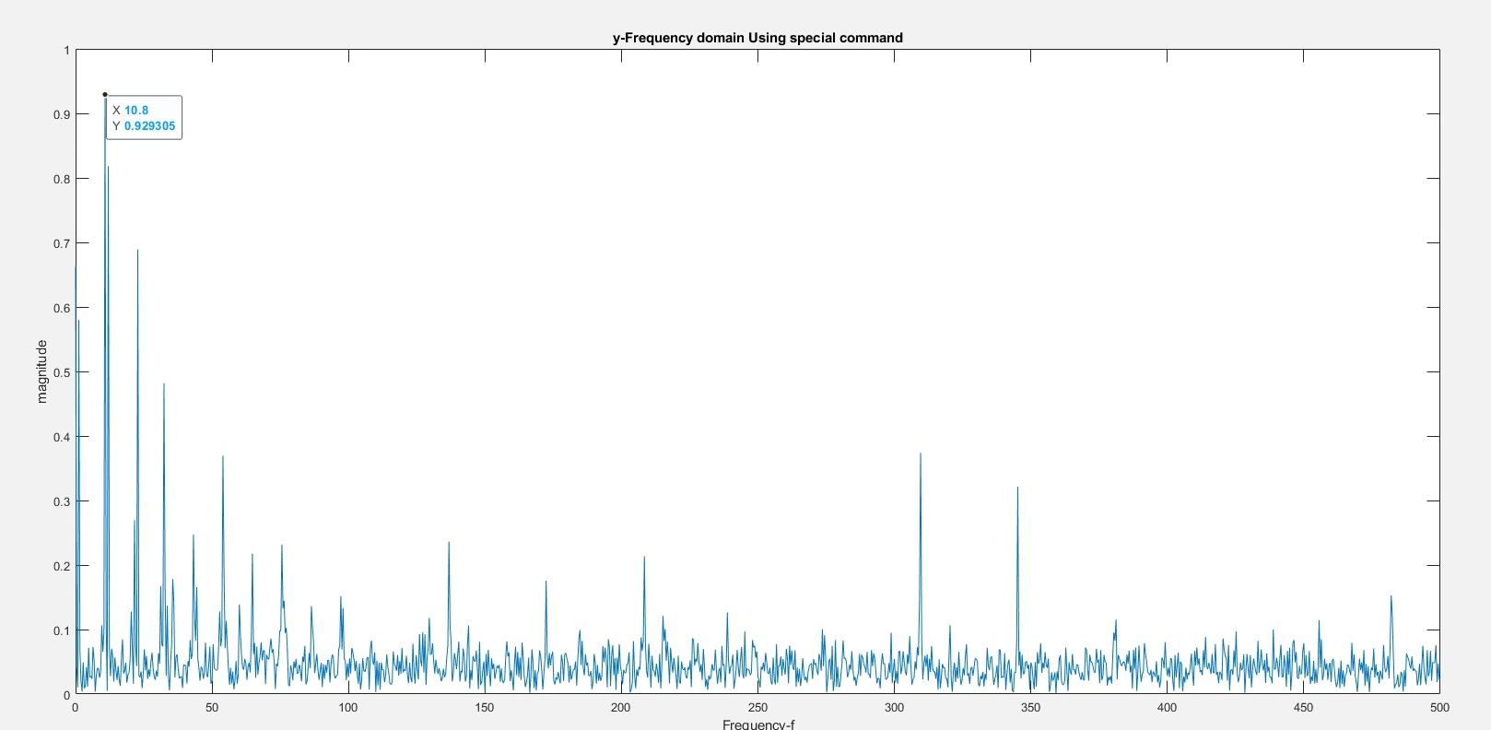
[picture p45: figure]

Signal Slower:

Original

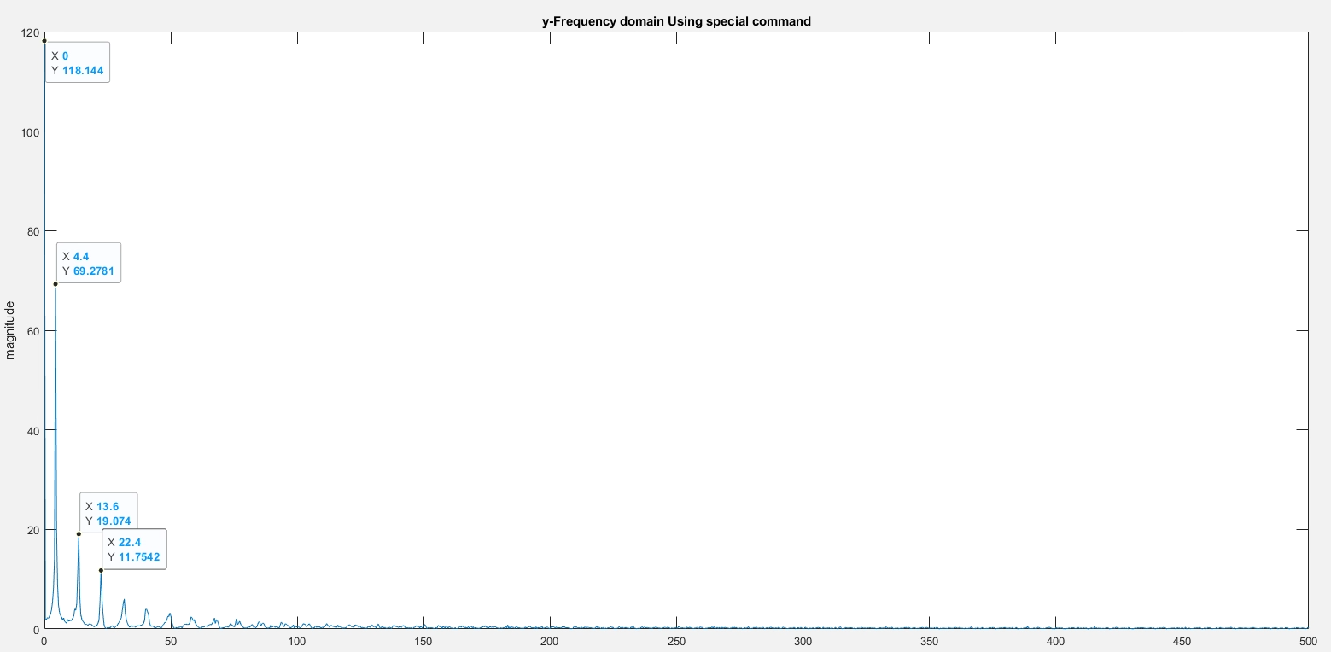
[picture p46: figure]

Noise only

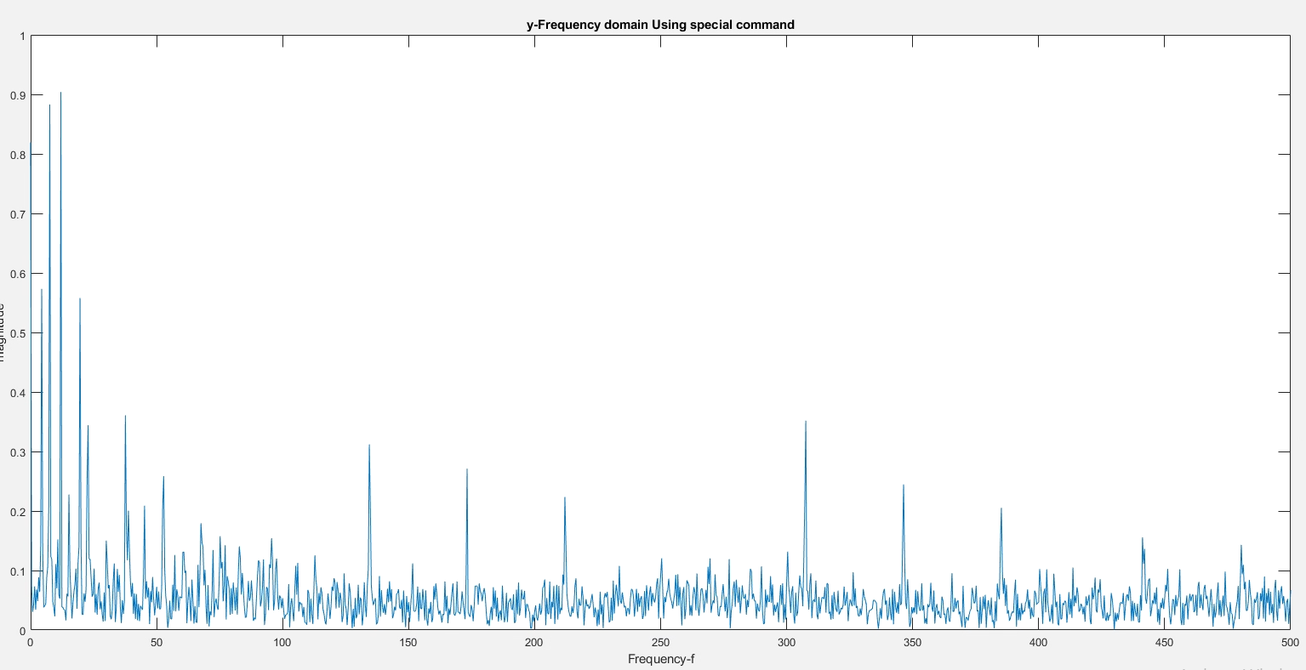
[picture p47: figure]

Signal Slowest:

Original

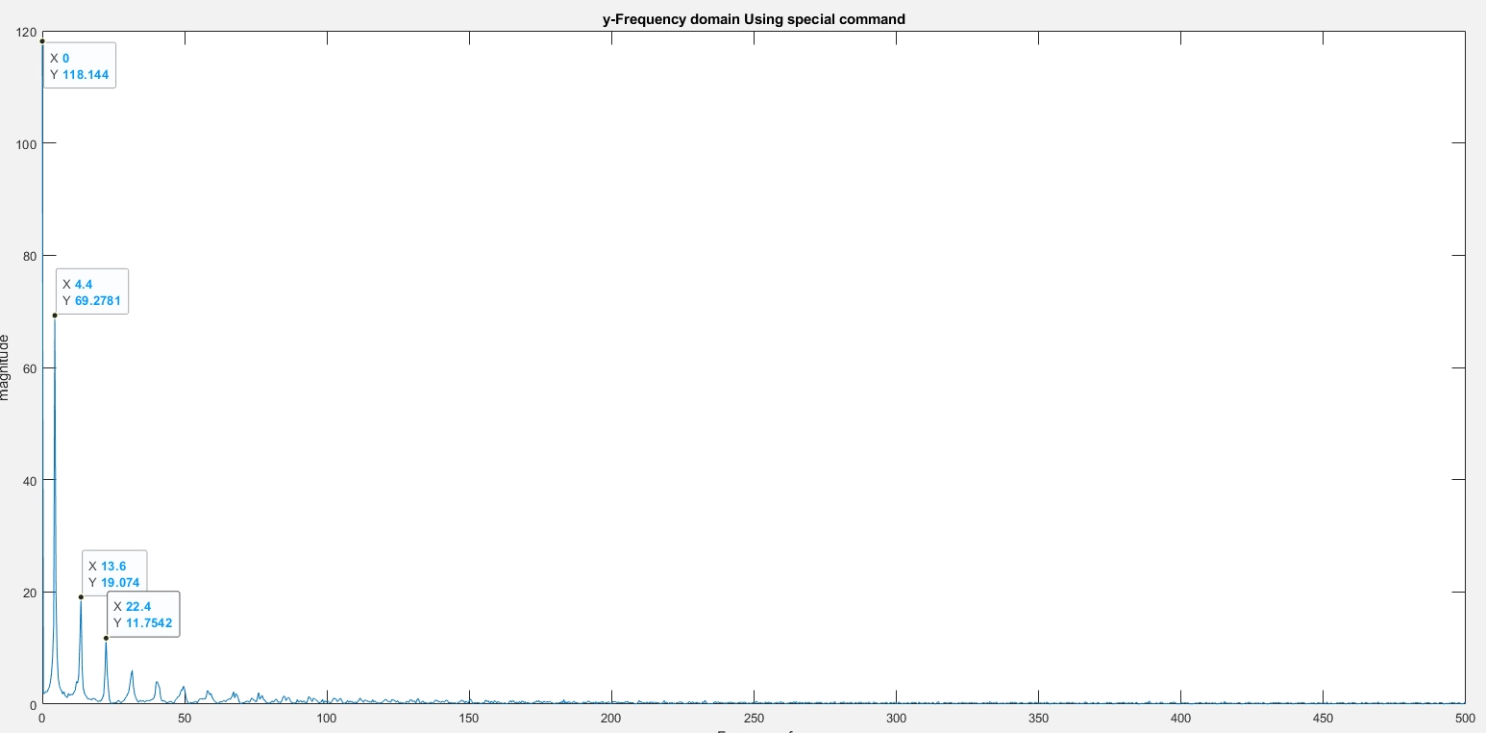
[picture p48: figure]

Noise only

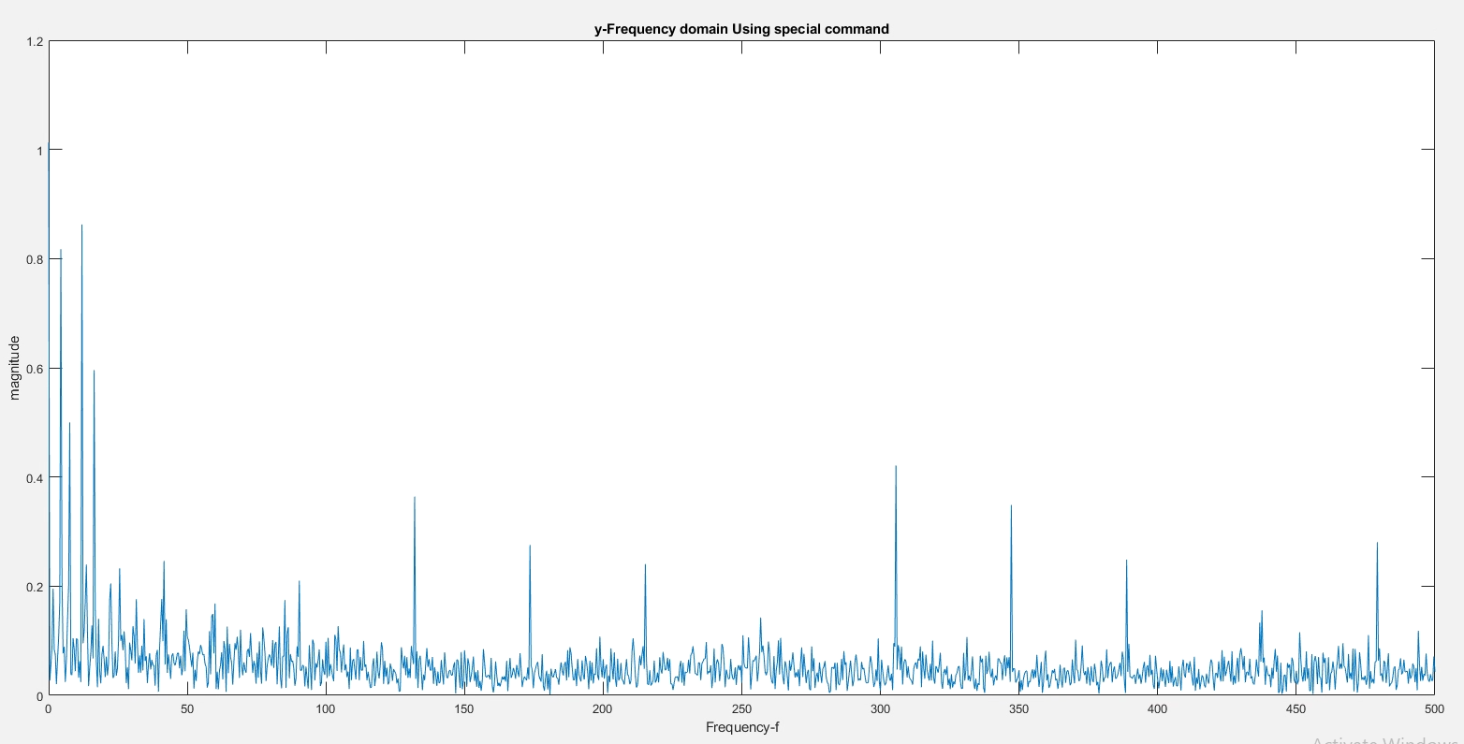
[picture p49: figure]

Signal not slowed 2:

Original

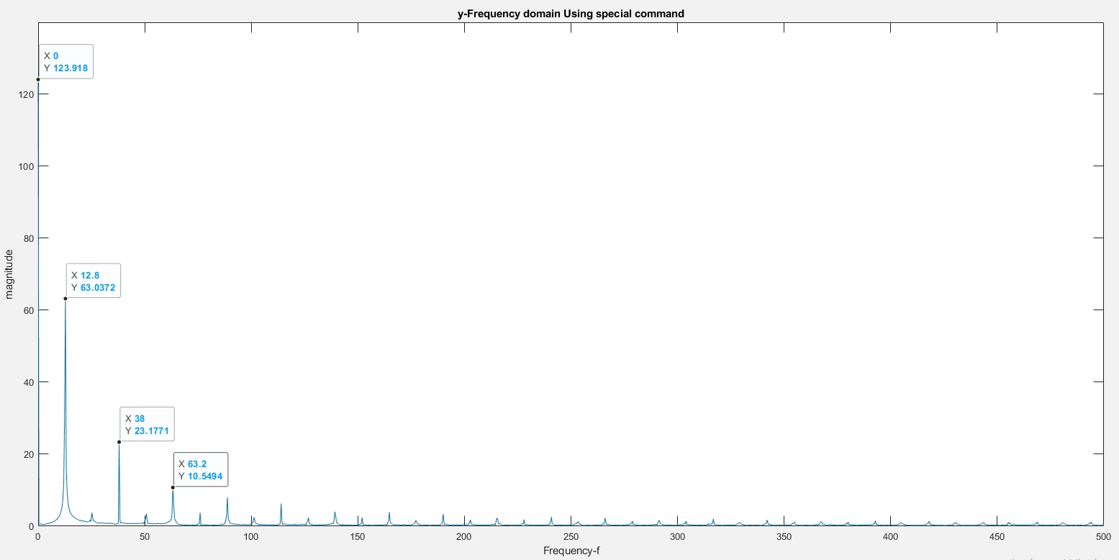
[picture p50: figure]

Noise only

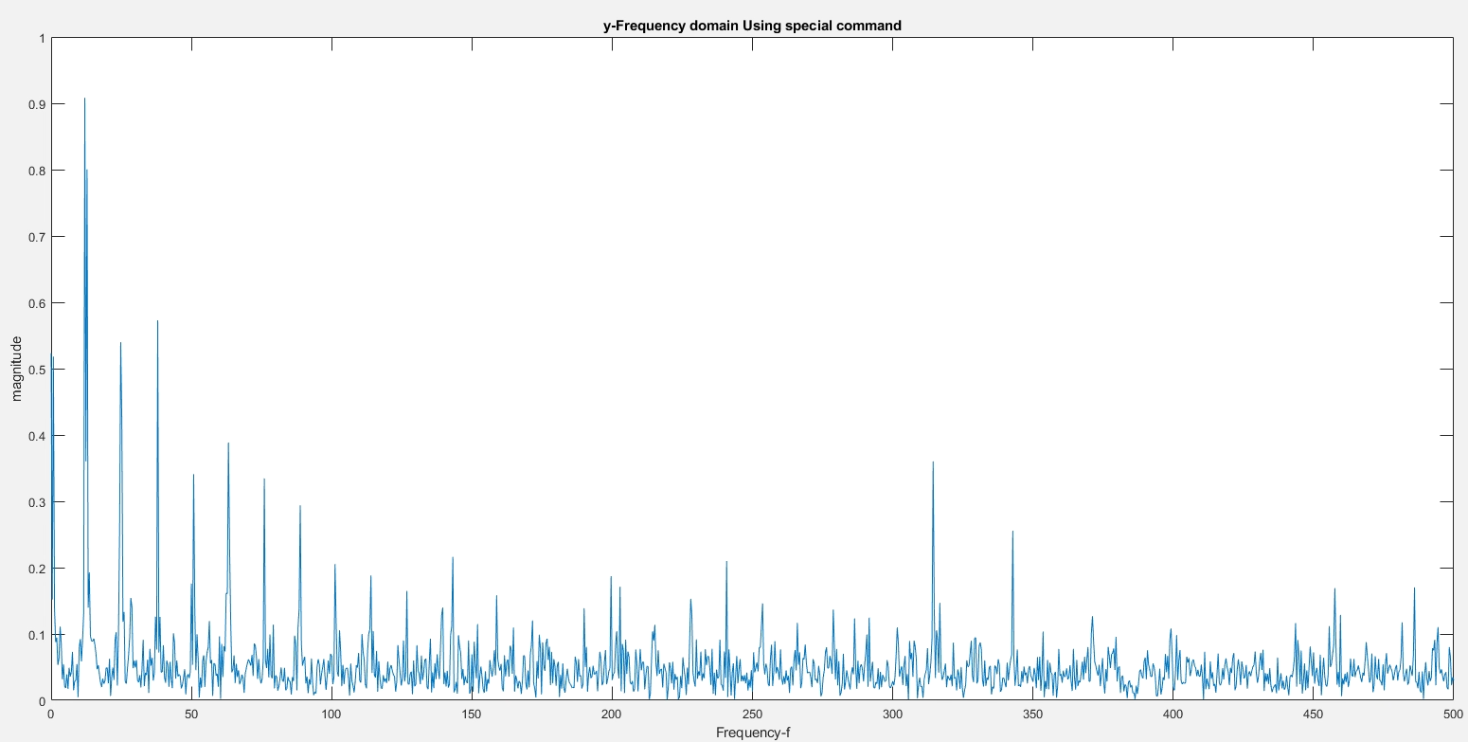
[picture p51: figure]
