R682T962/SDII/Textron Senior Design 1/Other/Data/FFT code and results/Try 1/Code for calculatons/Scope.xlsx

Data record 10/15 | Not slowed | slowed | slower | slowest | Not slowed | Noise | Not slowed | slowed | slower | slowest | Not slowed
 | 118 | 118 | 72 | 116 | 118 |  | -2 | -2 | 0 | -4 | -2
 | 120 | 118 | 42 | 62 | 118 |  | 0 | -2 | 0 | 0 | -2
 | 118 | 118 | 26 | 36 | 120 |  | -2 | -2 | 0 | 0 | 0
 | 120 | 120 | 16 | 20 | 118 |  | 0 | 0 | 0 | 0 | -2
 | 120 | 118 | 10 | 10 | 120 |  | 0 | -2 | 0 | 0 | 0
 | 120 | 118 | 6 | 6 | 118 |  | 0 | -2 | 6 | 6 | -2
 | 118 | 96 | 6 | 2 | 120 |  | -2 | 0 | 6 | 2 | 0
 | 120 | 54 | 4 | 2 | 120 |  | 0 | 0 | 4 | 2 | 0
 | 118 | 34 | 2 | 0 | 118 |  | -2 | 0 | 2 | 0 | -2
 | 118 | 20 | 2 | 0 | 120 |  | -2 | 0 | 2 | 0 | 0
 | 120 | 14 | 2 | -2 | 118 |  | 0 | 0 | 2 | -2 | -2
 | 120 | 8 | 2 | -2 | 120 |  | 0 | 8 | 2 | -2 | 0
 | 118 | 6 | 2 | -2 | 118 |  | -2 | 6 | 2 | -2 | -2
 | 118 | 6 | 2 | -2 | 120 |  | -2 | 6 | 2 | -2 | 0
 | 118 | 4 | 2 | -2 | 120 |  | -2 | 4 | 2 | -2 | 0
 | 118 | 2 | 2 | 2 | 120 |  | -2 | 2 | 2 | 2 | 0
 | 118 | 2 | 2 | -2 | 118 |  | -2 | 2 | 2 | -2 | -2
 | 120 | 2 | 2 | -2 | 120 |  | 0 | 2 | 2 | -2 | 0
 | 120 | 2 | 0 | -2 | 120 |  | 0 | 2 | 0 | -2 | 0
 | 118 | 2 | 0 | 0 | 118 |  | -2 | 2 | 0 | 0 | -2
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
