R682T962/SDII/Textron Senior Design 1/Other/Data/FFT code and results/Try 1/Scope reading 10-15.csv

Data record 10/15 | Not slowed | slowed | slower | slowest | Not slowed
 | 118 | 118 | 72 | 116 | 118
 | 120 | 118 | 42 | 62 | 118
 | 118 | 118 | 26 | 36 | 120
 | 120 | 120 | 16 | 20 | 118
 | 120 | 118 | 10 | 10 | 120
 | 120 | 118 | 6 | 6 | 118
 | 118 | 96 | 6 | 2 | 120
 | 120 | 54 | 4 | 2 | 120
 | 118 | 34 | 2 | 0 | 118
 | 118 | 20 | 2 | 0 | 120
 | 120 | 14 | 2 | -2 | 118
 | 120 | 8 | 2 | -2 | 120
 | 118 | 6 | 2 | -2 | 118
 | 118 | 6 | 2 | -2 | 120
 | 118 | 4 | 2 | -2 | 120
 | 118 | 2 | 2 | 2 | 120
 | 118 | 2 | 2 | -2 | 118
 | 120 | 2 | 2 | -2 | 120
 | 120 | 2 | 0 | -2 | 120
 | 118 | 2 | 0 | 0 | 118
 | 118 | 2 | 8 | 0 | 120
 | 118 | 2 | 0 | 2 | 120
 | 118 | 2 | 0 | -2 | 118
 | 118 | 2 | 0 | 0 | 118
 | 120 | 2 | 0 | 0 | 126
 | 118 | 0 | 0 | 0 | 118
 | 118 | 2 | -2 | 0 | 68
 | 118 | 2 | 0 | 0 | 40
 | 118 | 2 | 0 | 0 | 24
 | 118 | 2 | 0 | 0 | 14
 | 120 | 2 | 0 | 0 | 12
 | 118 | 2 | 0 | 0 | 4
 | 118 | 0 | 0 | 0 | 2
 | 68 | 0 | -2 | 0 | 0
 | 40 | 0 | -2 | 2 | 0
 | 22 | 2 | 0 | 2 | 0
 | 16 | 0 | 0 | 2 | 0
 | 6 | 2 | -2 | 2 | -2
 | 2 | 0 | -2 | 4 | -2
 | 2 | 0 | -2 | 2 | -2
 | 0 | 0 | -2 | 2 | -2
 | 0 | 0 | -2 | 2 | -2
 | -2 | 0 | -2 | 2 | -2
 | -2 | 0 | 0 | 2 | -2
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
