R682T962/SDII/Textron Senior Design 1/Integrator_comp_mel2.asc

C1: cap; 10µF
R1: res; 220
R2: res; 1.4k
R3: res; 4k
R4: res; 2.8k
R5: res; 100
R8: res; 1000
U2: LT1638
V1: voltage; PULSE(0 5 0 0.01m 0.01m 8m 16m)
V2: voltage; 0.9
V3: voltage; 5
V4: voltage; 0
Named nets: 0, Vin, Vout, Vcc, -Vcc, Cout
.tran 0 1.25 1 startup
.meas Vmax MAX V(vout)
.meas Vmin MIN V(vout)
