R682T962/SDII/Textron Senior Design 1/Low pass filter_comp_mel.asc

C1: cap; .7µF
C2: cap; .8pF
R1: res; 220
R2: res; 220
R3: res; 1000
R4: res; 100
R5: res; 100
R8: res; 10000
U2: LT1638
V1: voltage; PWL file="C:\Users\Vikki\OneDrive\Desktop\-Senior Design 1\Low pass filter\Test files\Scope slowest readings.txt"
V2: voltage; 11.5
V3: voltage; 12
V4: voltage; 12
Named nets: 0, Vin, Vout, Vcc, -Vcc, Cout
.tran 0 .25 0
