R682T962/SDII/Textron Senior Design 1/int-OS-SK-C+.asc

C1: cap; 10n
C2: cap; 10n
C3: cap; 10n
C4: cap; 1µ
C5: cap; 1µ
C6: cap; 10n
D1: diode
M1: pmos
M2: pmos
R1: res; 1Meg
R2: res; 100k
R3: res; 100k
R4: res; 10k
R5: res; 4k
R6: res; 1k
R7: res; 12k
R8: res; 1k
R9: res; 9
U1: NE555
U2: LT1638
U3: LT1638
V1: voltage; 5
V2: voltage; 5
V3: voltage; PULSE(0 5 0 0.01m 0.01m 6m 12m)
V4: voltage; 2.45
Named nets: 0, Vcc, Vtrig, -Vcc, PWM, avg, Vref, comparator
.tran 0 2 1
