R682T962/SDII/Textron Senior Design 2/Other/Current work summary/Textron Cooling Fan Schematic capacitor added.asc

C1: cap; 10n
C2: cap; 1µ
C3: cap; 10n
C4: cap; 10n
C5: cap; 10µ
C6: cap; 10µ
C7: cap; 1µ
C8: cap; 100n
C9: cap; 100n
C10: cap; 100n
C11: cap; 1µ
C12: cap; 100n
C13: cap; 100n
D1: diode; 1N4148
D2: diode; 1N4148
D3: diode; 1N4148
D4: TVSdiode; MyTVS
M1: nmos; Si7336ADP
R1: res; 33k
R2: res; 1k
R3: res; 5k
R4: res; 10k
R5: res; 10k
R6: res; 100k
R7: res; 100k
R8: res; 1k
R9: res; 20k
R10: res; 220
R11: res; 100k
R12: res; 100k
R13: res; 98k
R14: res; 5
R15: res; 10k
U1: LT1638
U2: NE555
U3: LT1638
U4: LT1638
U5: LT1021-5
V1: voltage; 28
V3: voltage; PULSE(0 5 0 0.01m 0.01m 11.25m 22.5m)
Named nets: 0, Vcc, Vtrig, PWM, avg, Vref, comparator, buffer, Output, V1
.tran 0 2 1
.model MyTVS d Ron=10m Vfwd=90 Vrev=90 Epsilon=1 RevEpsilon=1
