R682T962/SDII/Textron Senior Design 2/Other/Current work summary/Power Bus Regulation.asc

C1: cap; 100n
D1: TVSdiode; MyTVS
R1: res; 100k
R2: res; 100k
U1: LT1021-5
V1: voltage; 28
Named nets: 0, Vbus, Vout, Half-Vout
.tran 0 1 0.001
.model MyTVS d Ron=10m Vfwd=90 Vrev=90 Epsilon=1 RevEpsilon=1
