R682T962/SDII/Textron Senior Design 2/Other/LTspice Models/Cody/Schmitt Trigger Buffer.asc

D1: diode; 1N4148
D2: diode; 1N4148
R1: res; 33k
R2: res; 1k
U1: LT1638
V1: voltage; 5
V2: voltage; PULSE(0 5 0 0.01m 0.01m 11.25m 22.5m)
Named nets: 0
.tran 0 3 0
