R682T962/SDII/Textron Senior Design 1/Other/LTspice Models/Melvin/Low pass filter two.asc

C1: cap; 1.µ
R1: res; 50
V1: voltage; PWL file="C:\Users\Vikki\OneDrive\Desktop\-Senior Design 1\Low pass filter\Test files\Scope fastes1 readings.txt"
Named nets: 0, Vout
.tran 0 .25 0
