R682T962/SDII/Textron Senior Design 2/Other/LTspice Models/Ayham/MOSFET circuit Ayham.asc

Compacto_input_0or5: voltage; 5
M2: nmos; Si7336ADP
Pull_up_resistor: res; 5
R3: res; 220
Vcc: voltage; 5
Named nets: 0
.tran 10
