R682T962/SDII/Textron Senior Design 2/Other/LTspice Models/Cody/Differentiator + Monostable Vibrator + Sallen Key.asc

C1: cap; 10n
C2: cap; 10n
C3: cap; 10n
C4: cap; 1µ
C5: cap; 1µ
C6: cap; 10n
D1: diode
R1: res; 100k
R2: res; 100k
R3: res; 100k
R4: res; 5k
R5: res; 5k
U1: NE555
U2: LT1638
V1: voltage; 5
V2: voltage; 5
V3: voltage; PULSE(0 12 0 0.01m 0.01m 1m 2m)
Named nets: 0, Vcc, Vtrig, -Vcc
.tran 0 2 1
