R682T962/SDII/Textron Senior Design 2/Other/LTspice Models/Cody/F to V using 555 Timer.asc

C1: cap; 10n
C2: cap; 10n
C4: cap; 100nF
R2: res; 150k
R3: res; 10k
R4: res; 10k
R5: res; 200k
U1: NE555
U2: LT1638
V1: voltage; PULSE(0 5 0 10u 10u 1m 2m)
V2: voltage; 4
V3: voltage; 2.4
Named nets: 0, Vin, Vout
.tran 0 1.25 1 startup
