R682T962/SDII/Textron Senior Design 2/Other/LTspice Models/Cody/Sallen-Key Low-pass Filter.asc

C1: cap; 25n
C2: cap; 50n
R1: res; 15k
R2: res; 15k
U1: LT1638
V1: voltage; PULSE(0 12 0 0.01m 0.01m 1m 2m)
V2: voltage; 5
Named nets: 0
.tran 0 5 1
