R682T962/SDII/Textron Senior Design 1/Other/LTspice Models/Melvin/Low pass filter.asc

C1: cap; 1µ
R1: res; 150
R2: res; 1000k
V1: voltage; PWL file="D:\My stuff\personal\School work\Uni 2021 Fall\Senior Design Project I\LT spice\Low pass filter\Test files\Scope fastes1 readings.txt"
Named nets: 0
.tran 0 .25 0
