R682T962/SDII/Textron Senior Design 1/Other/LTspice Models/Ayham/Buck convert step down/Buck convert step down.asc

C1: cap; 10ľ
D1: diode
L1: ind; 2
R1: res; 100
V1: voltage; PULSE(0 12 0 0.01m 0.01m 11m 91m)
Named nets: 0
.tran 0 1 0
