R682T962/SDII/Textron Senior Design 1/Other/LTspice Models/Ayham/for Square wave/Low_pass_filter_comp_mel_3.asc

C1: cap; 70µF
R1: res; 220
R2: res; 220
R3: res; 100
R4: res; 1000
R5: res; 100
R8: res; 1000
U2: LT1638
V1: voltage; PULSE(0 5 0 0.01m 0.01m 7m 14m)
V2: voltage; 2
V3: voltage; 5
V4: voltage; 0
Named nets: 0, Vin, Vout, Vcc, -Vcc, Cout
.tran 0 .25 0 startup
