R682T962/SDII/Textron Senior Design 1/Other/LTspice Models/Ayham/input filtering with schmitt trigger/input filtering with schmitt trigger 2.asc

R1: res; 500
R2: res; 22k
U1: LT1638
V1: voltage; 10
V2: voltage; PWL file="D:\My stuff\personal\School work\Uni 2021 Fall\Senior Design Project I\LT spice\OLD\FFT\input\25ms 12V data0 divide 10.txt"
V3: voltage; 12
Named nets: 0, Vcc
.tran 0 25m 0
