R682T962/SDII/Textron Senior Design 1/Other/LTspice Models/Ayham/one shot - Continued from here for next semester/int-OS-SK-C.asc

C1: cap; 10n
C2: cap; 10n
C3: cap; 10n
C4: cap; 1µ
C5: cap; 1µ
C6: cap; 10n
D1: diode
R1: res; 1Meg
R2: res; 100k
R3: res; 100k
R4: res; 10k
R5: res; 4k
R6: res; 50
R7: res; 12k
U1: NE555
U2: LT1638
U3: LT1638
V1: voltage; 5
V2: voltage; 5
V3: voltage; PULSE(0 5 0 0.01m 0.01m 12m 24m)
V4: voltage; 3
Named nets: 0, Vcc, Vtrig, -Vcc, PWM, avg, Vref, compactor
.tran 0 2 1
