R682T962/SDII/Textron Senior Design 1/Other/LTspice Models/Ayham/one shot - Continued from here for next semester/one shot.asc

C1: cap; 10n
C2: cap; 100µ
R1: res; 100
R2: res; 1k
R3: res; 1k
U1: NE555
V1: voltage; 5
V2: voltage; 5
V3: voltage; PULSE(0 5 0 0.01m 0.01m 7m 20m)
Named nets: 0, Vcc, -Vcc, Vin, Vout, Vouthalf
.tran 0 1.25 1
