R682T962/SDII/Textron Senior Design 1/Other/LTspice Models/Ayham/Sallen Key/Sallen key.asc

C1: cap; 1µ
C2: cap; 1µ
R1: res; 100k
R2: res; 100k
U1: LT1638
V1: voltage; 12
V2: voltage; 12
V5: voltage; PULSE(0 12 0 0.1us 0.1us 11ms 22ms)
Named nets: 0, V+, PWM, V-
.tran 0 5 2
