R682T962/SDII/Textron Senior Design 1/Other/LTspice Models/Ayham/one shot - Continued from here for next semester/Cody D-OS-SK/Differentiator__Monostable_Vibrator__Sallen_Key.asc

C1: cap; 10n
C2: cap; 10n
C3: cap; 10n
C4: cap; 50n
C5: cap; 100n
C6: cap; 10n
D1: diode
R1: res; 115k
R2: res; 30k
R3: res; 30k
R4: res; 10k
R5: res; 5k
U1: NE555
U2: LT1638
V1: voltage; 12
V2: voltage; 12
V3: voltage; PULSE(0 12 0 0.01m 0.01m 30m 60m)
Named nets: 0, Vcc, Vtrig, -Vcc
.tran 0 2 1
