R682T962/SDII/Textron Senior Design 1/Other/LTspice Models/Ayham/one shot - Continued from here for next semester/mel Sallen key/Sallen key Mel.asc

C1: cap; 10n
C2: cap; 10n
C4: cap; 10n
C5: cap; 10n
C6: cap; 10n
D1: diode
R1: res; 1Meg
R2: res; 1k
R3: res; 1k
R4: res; 5
R5: res; 10k
R6: res; 15
R7: res; 15
R8: res; 1
U1: NE555
U2: LT1638
U3: LT1638
V1: voltage; 12
V2: voltage; 12
V3: voltage; PULSE(0 12 0 0.01m 0.01m 1.25m 2.5m)
Named nets: 0, Vcc, Vtrig, -Vcc, Vout, Vouthalf, FilterOut
.tran 0 2 1
