R682T962/SDII/(list of files, drawings)

Other design files:
Textron Senior Design 2/Other/Altium/Melvin/PCB1.PcbDoc
Textron Senior Design 2/Other/Altium/Melvin/Textron PCB Project.SchDoc
