R682T962/SDII/(commit log)

2022-02-25 Rename Textron Senior Design 1/Low pass filter_comp_mel.asc to Textron Senior Design 1/Other/LTspice Models/Melvin/Low pass filter_comp_mel.asc
2022-02-25 Rename Textron Senior Design 1/Low pass filter_comp_mel_2.asc to Textron Senior Design 1/Other/LTspice Models/Melvin/Low pass filter_comp_mel_2.asc
2022-02-27 Rename Textron Senior Design 1/Other/LTspice Models/LTspice/Buck convert step down/Buck convert step down.asc to Textron Senior Design 1/Other/LTspice Models/Ayham/Buck convert step down/Buck convert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
